pozdezh/Project_DELTA_Ph1/examples.jpg

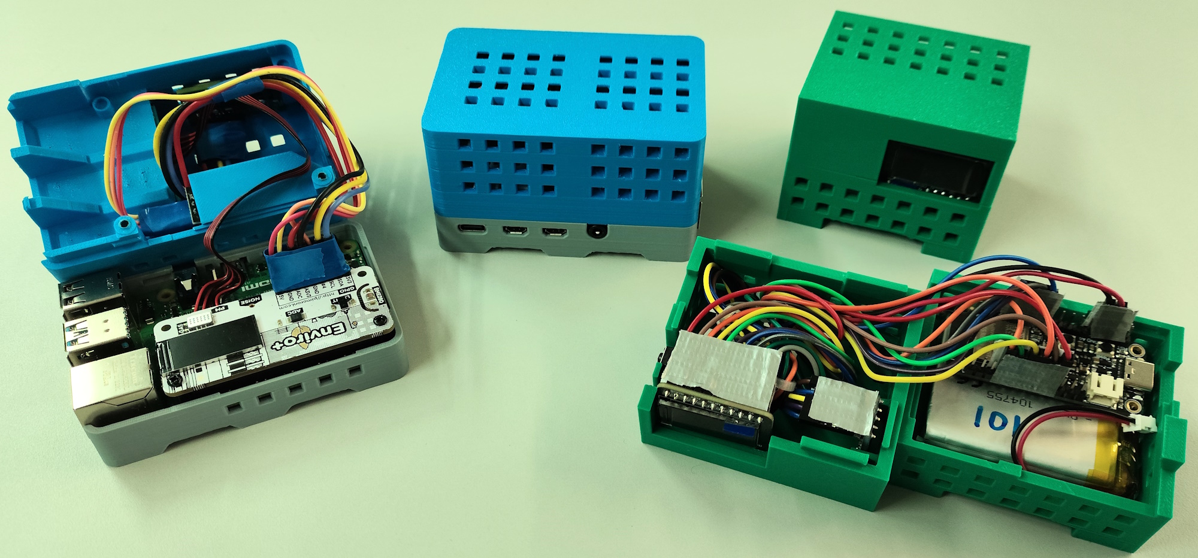
examples.jpg
