pozdezh/Project_DELTA_Ph1/README.md

# Project_DELTA_Ph1
TFG1 (GEB); 1st phase out of 2 in Smart Classroom final degree/research projects.

Task: Development of two sensor kits using IoT technology to measure, on the one hand, air quality and, on the other hand, noise. Study correlations between these factors based on measurements taken in a small office space.

The following research publication has resulted from the
study carried out in this work:

Edgar Batista, Constantin Shoot, Agustí Solanas, and Antoni Martínez-Ballesté, “Self-Organising and Autonomous IoT-based Monitoring Units
for Smart Environments”, 13th International Conference on Applications
in Electronics Pervading Industry, Environment and Society (ApplePies),
Torino, Italy, 11–12 September 2025.

This project builds on prior work:

E. Batista, A. Martínez-Ballesté, J. Rosell-Llompart, and A. Solanas.
"Towards Context-Aware Classrooms: Lessons Learnt from the ACTUA Project."
In: F. Bellotti et al. (eds) Applications in Electronics Pervading Industry,
Environment and Society. ApplePies 2023. Lecture Notes in Electrical Engineering, vol 1110.
Springer, Cham. https://doi.org/10.1007/978-3-031-30333-3_45
