pozdezh/Project_DELTA_Ph1/AirQ/Code/README.md

This code builds on prior research from the ACTUA Project, and has been adapted for the current Smart Environments project.

Prior work:

E. Batista, A. Martínez-Ballesté, J. Rosell-Llompart, and A. Solanas.
"Towards Context-Aware Classrooms: Lessons Learnt from the ACTUA Project."
In: F. Bellotti et al. (eds) Applications in Electronics Pervading Industry, Environment and Society (ApplePies 2023), Lecture Notes in Electrical Engineering, vol 1110. Springer, Cham.
https://doi.org/10.1007/978-3-031-30333-3_45

Current work:

E. Batista, C. Shoot, A. Solanas, and A. Martínez-Ballesté.
"Self-Organising and Autonomous IoT-based Monitoring Units for Smart Environments."
Smart Technologies Research Group, Universitat Rovira i Virgili.
