pozdezh/Project_DELTA_Ph1/docs/TFG_Shoot_Biomed.pptx

Constantin Shoot Vayevoda

Development of a Contextual Sensing Kit to Assess the Relationship Between Air Quality and Noise

Treball de Fi de Grau en Enginyeria Biomèdica

dirigit per Edgar Batista de Frutos i Antoni Martínez Ballesté

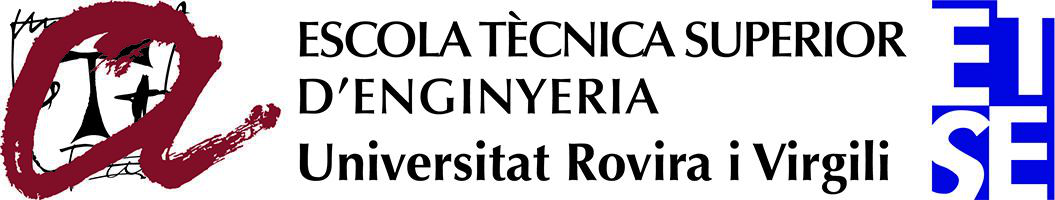
[picture p2: figure]

Tarragona

2025

## Contents

1. Introduction & Motivation
2. Objectives & Theoretical Basis
3. Design & Implementation
4. Validation & Experiment Setup
5. Results & Discussion
6. Future Work
7. Conclusions

## 1: Motivation and problem

- IEQ impacts comfort and learning
- Current solutions are ad hoc, hard to compare
- Issues: heterogeneity, manual setup, weak synchronisation
- Need modular kits with accurate timestamping and privacy

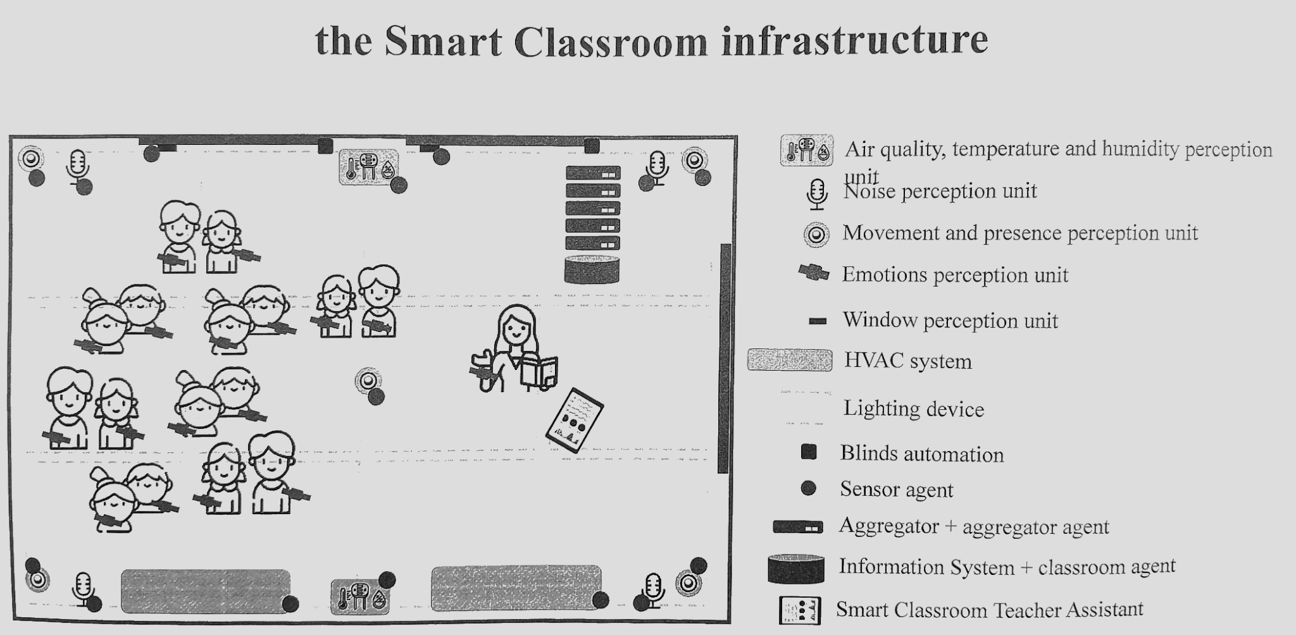
[picture p3: figure]

## 2.1: Objectives

- Build two modular kits: AirQ (air quality) & Noise (voice-band)
- Accurate, timestamped on-device data retention; light IoT hooks
- Compact 3D-printed enclosures for indoor use
- Validate in real context; initial air–noise correlation analysis
- Phase 1 groundwork boundary: networking & cloud deferred to Phase 2

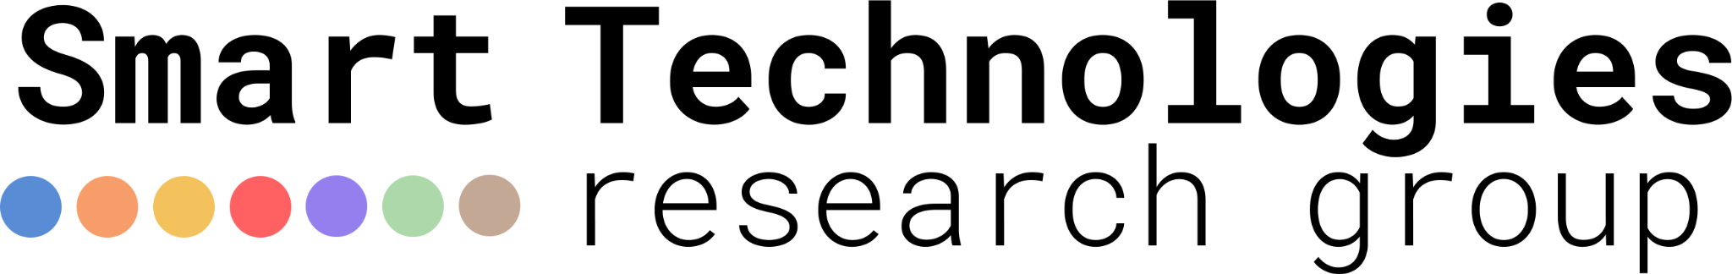
[picture p4: figure]

## 2.2: RTOS and ESP32

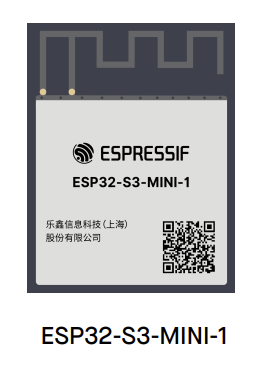
[picture p5: figure]
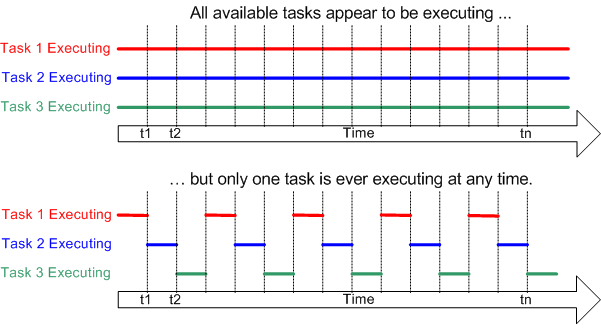
[picture p6: figure]
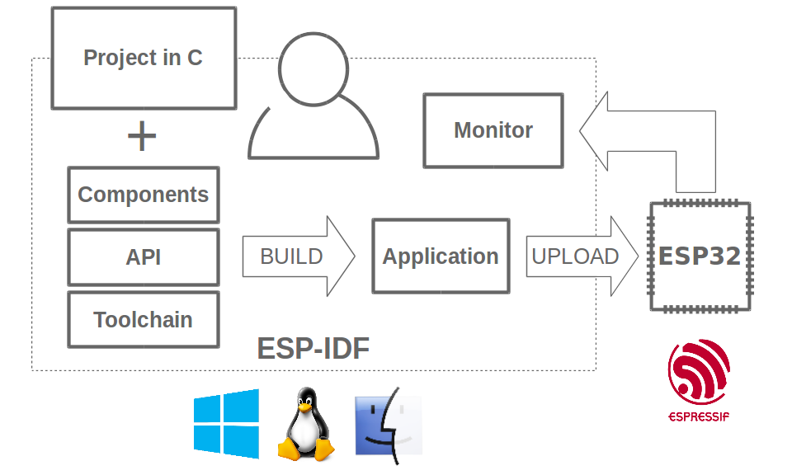
[picture p7: figure]

www.espressif.com

www.freertos.org

## 2.3: Discrete Fourier Transform and FFT

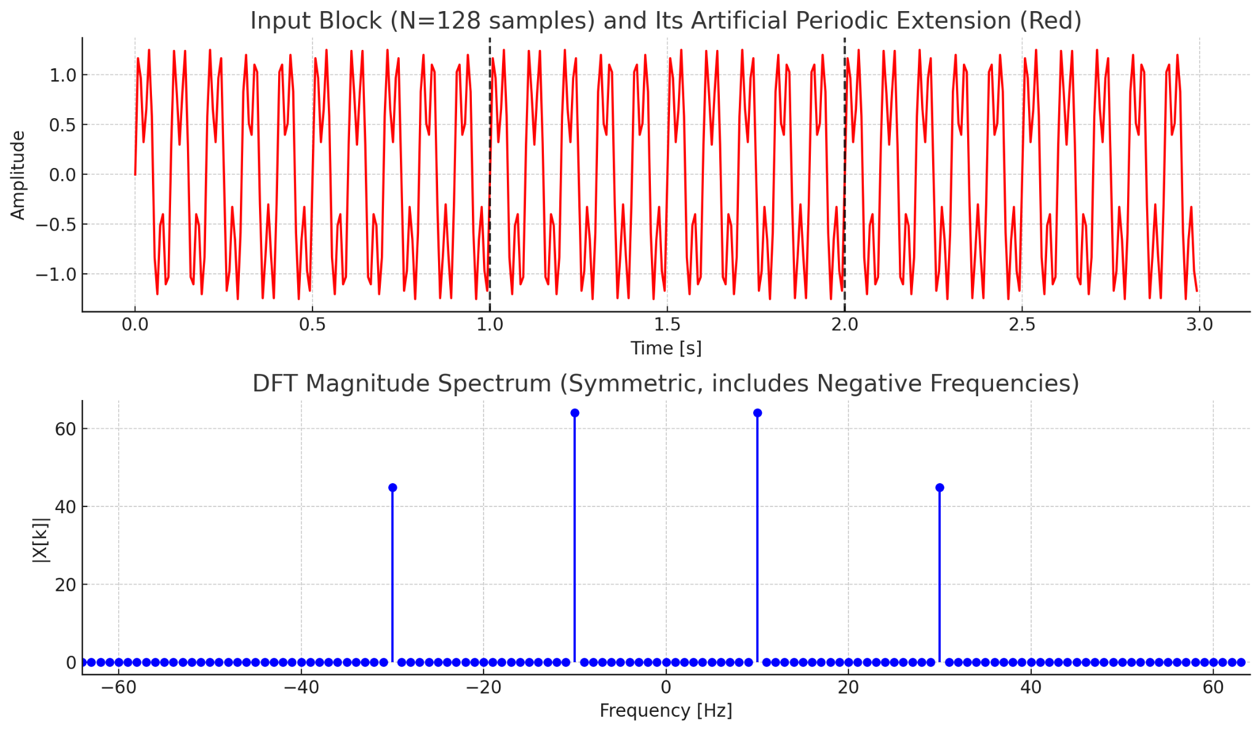
[picture p8: figure]
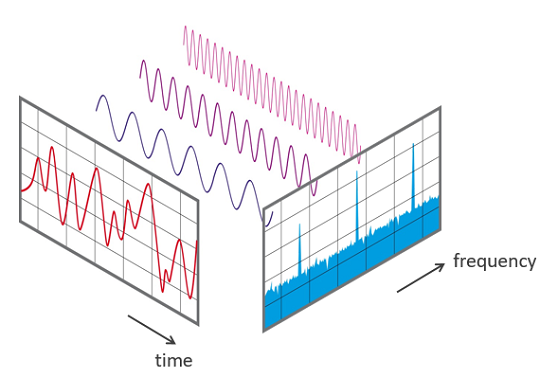
[picture p9: figure]

www.allaboutcircuits.com

## 2.3: “Speech Banana”

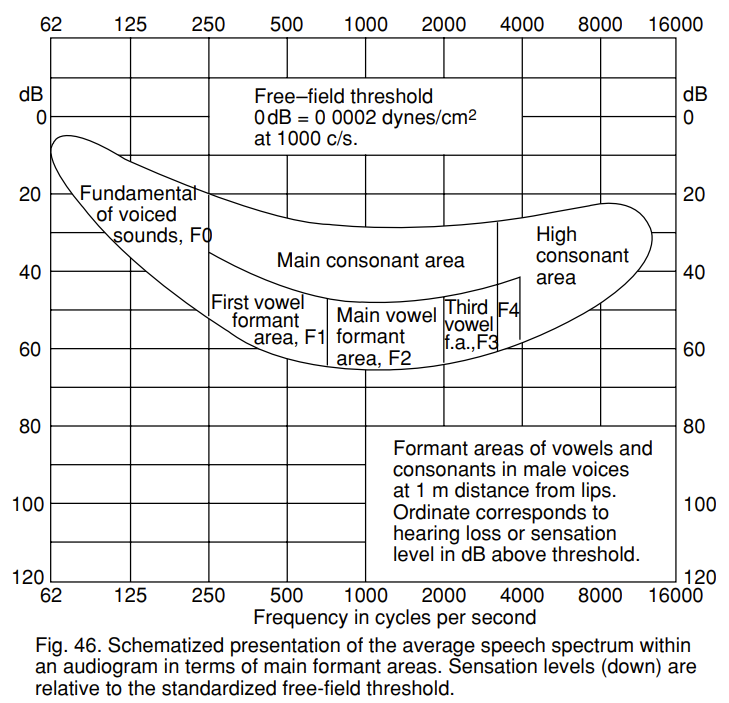
[picture p10: figure]

## 2.4: 3D printing and PLA

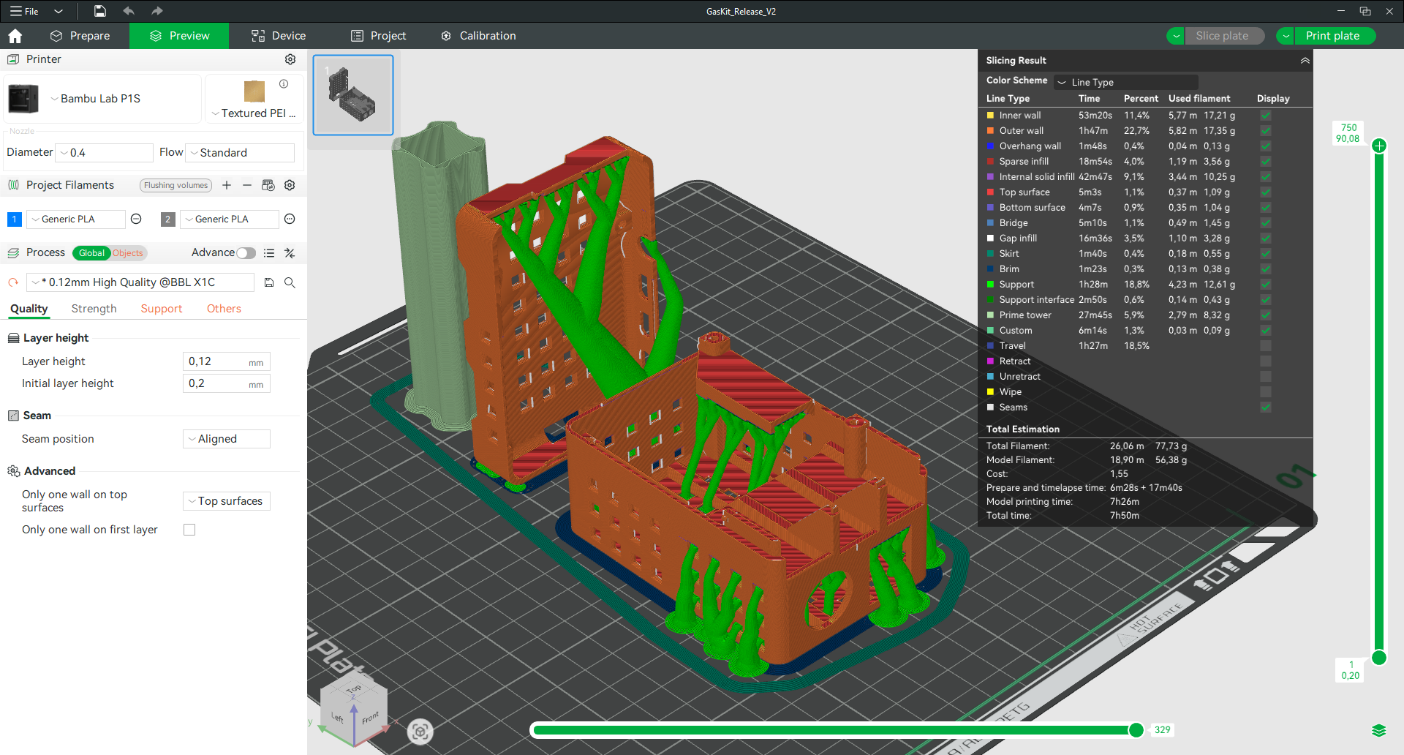
[picture p11: figure]
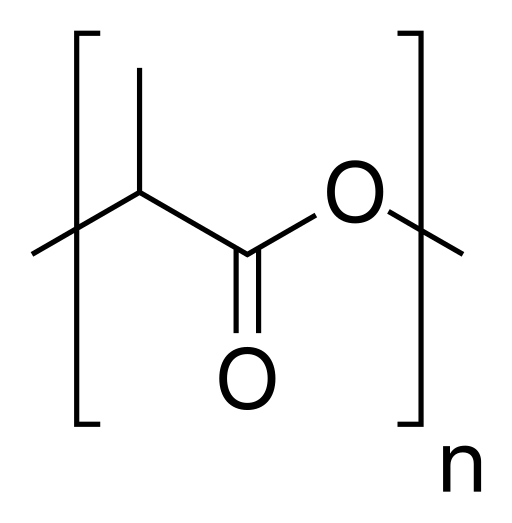
[picture p12: figure]

## 2.5: Data science

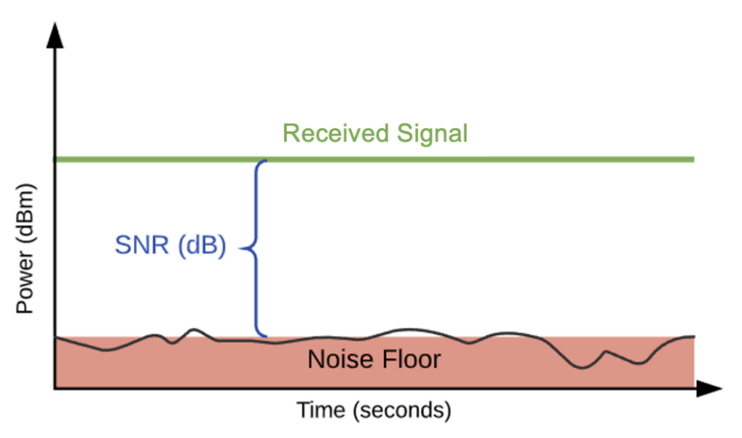
[picture p13: figure]
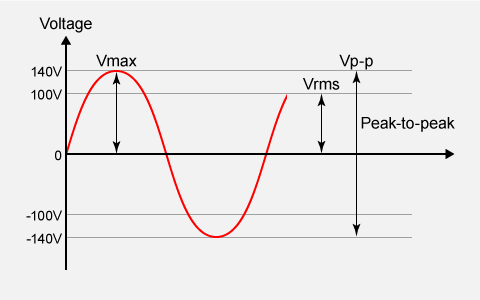
[picture p14: figure]

www.hollyland.com

www.matsusada.com

## 2.5: Data science

- H0/H1 testing for Pearson r
- Lagged alignment
- Autocorrelation addressed
- False discovery rate
- Slow trends considered

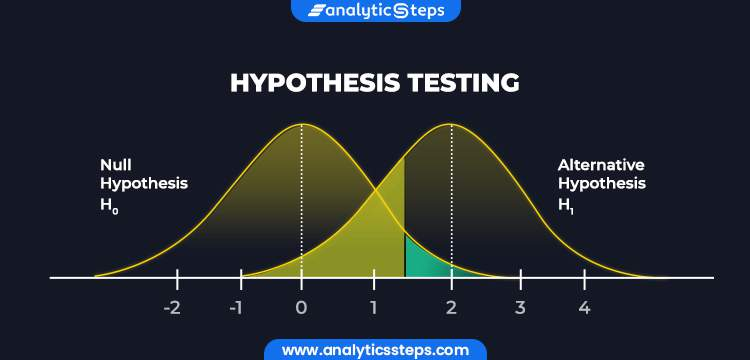
[picture p15: figure]

## 3.1: Budget

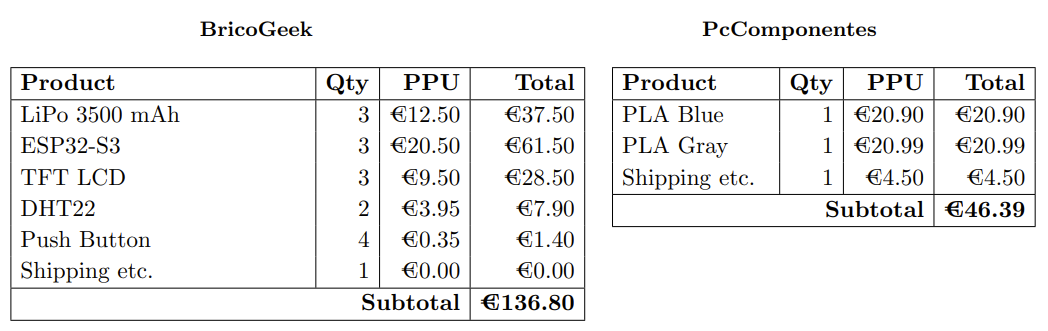
[picture p16: figure]

## 3.2: Kits produced

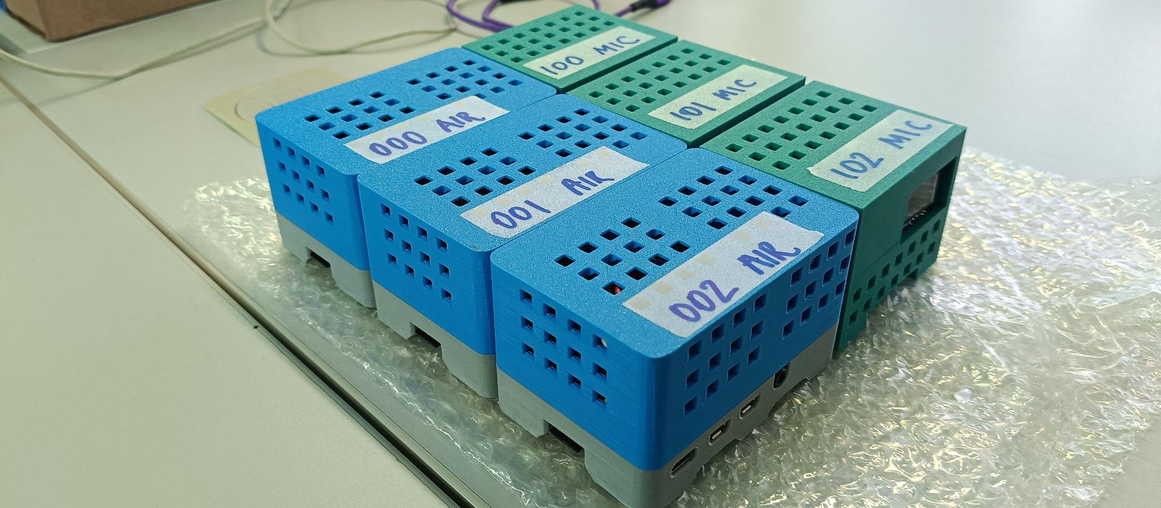
[picture p17: figure]
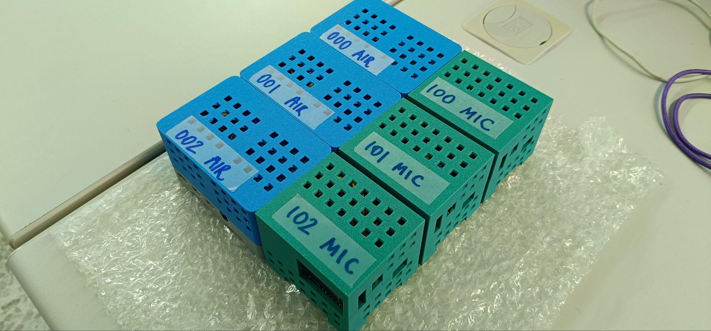
[picture p18: figure]
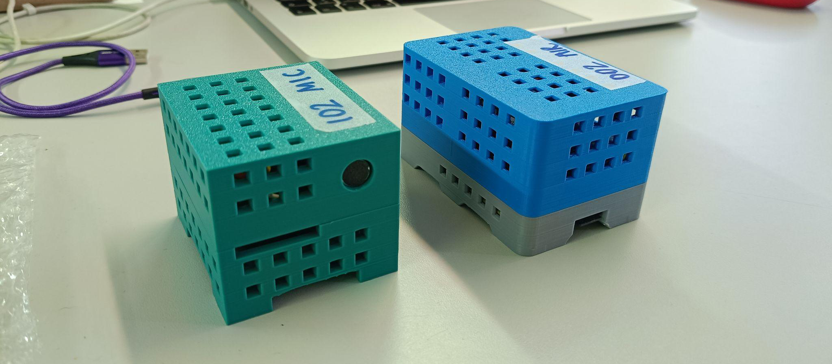
[picture p19: figure]

## 3.3: AirQ kit hardware

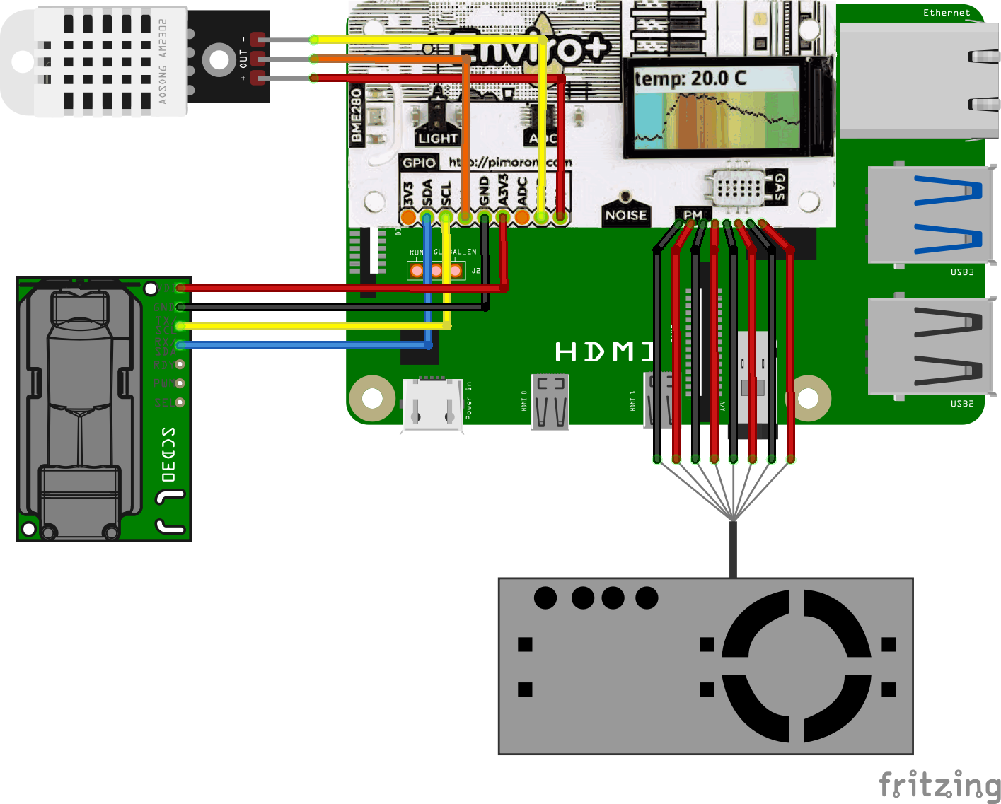
[picture p20: figure]

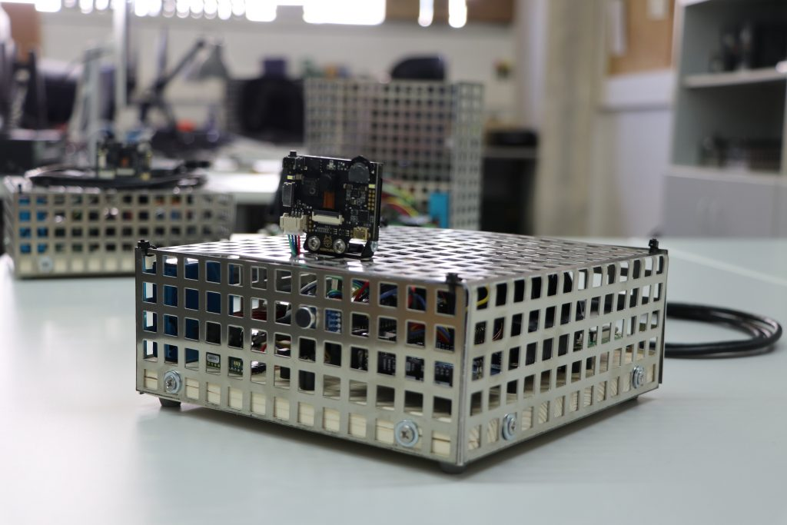
[picture p21: figure]

## 3.3: AirQ kit hardware

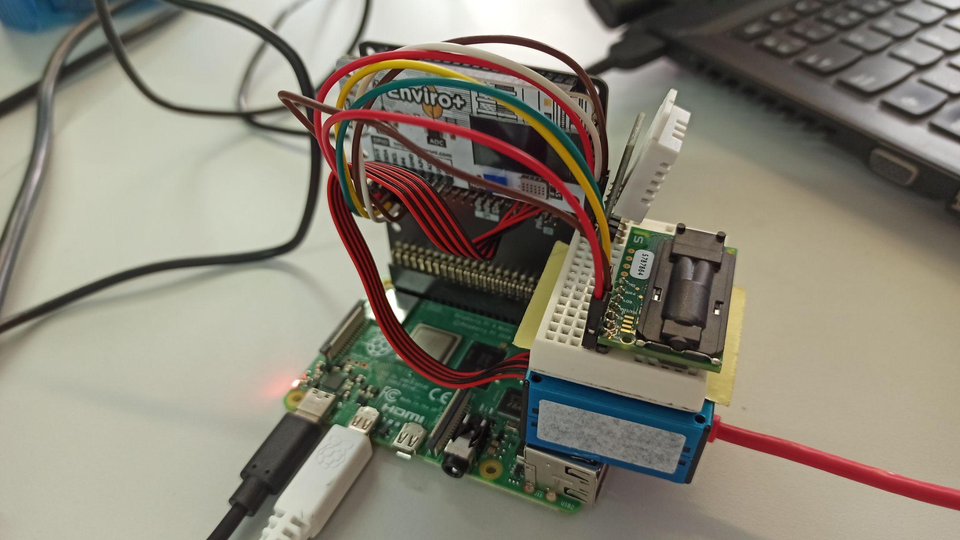
[picture p22: figure]
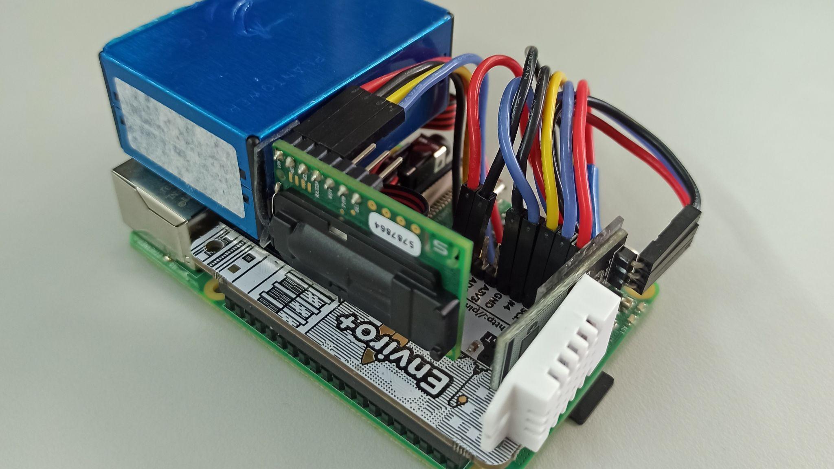
[picture p23: figure]

## 3.4: AirQ kit enclosure

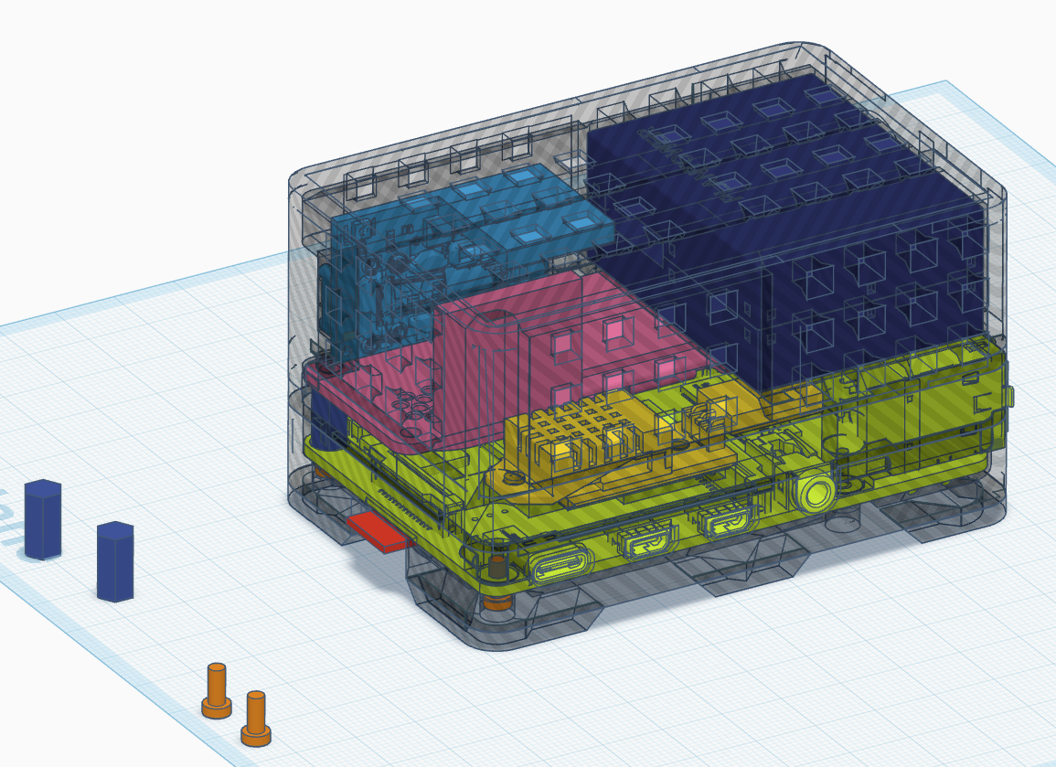
[picture p24: figure]
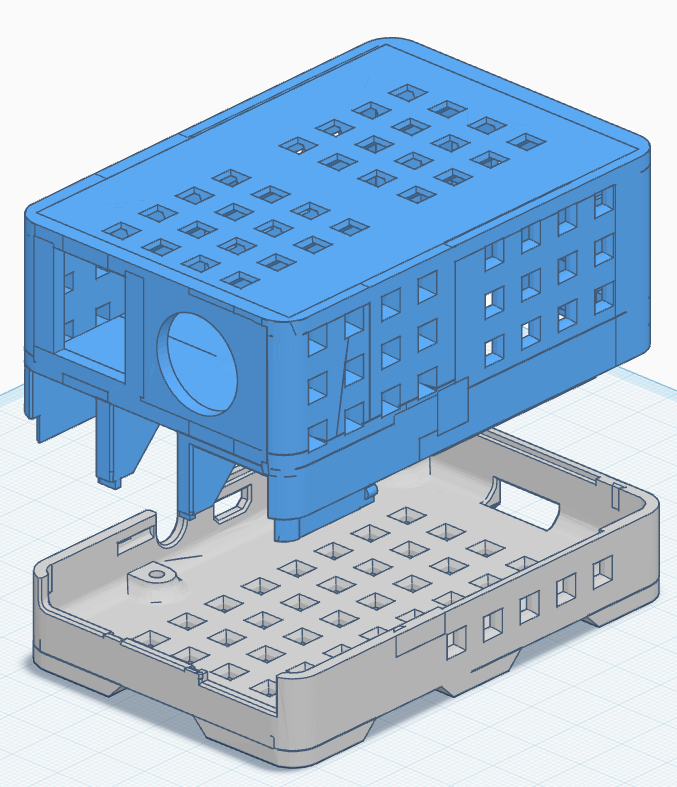
[picture p25: figure]

## 3.4: AirQ kit enclosure

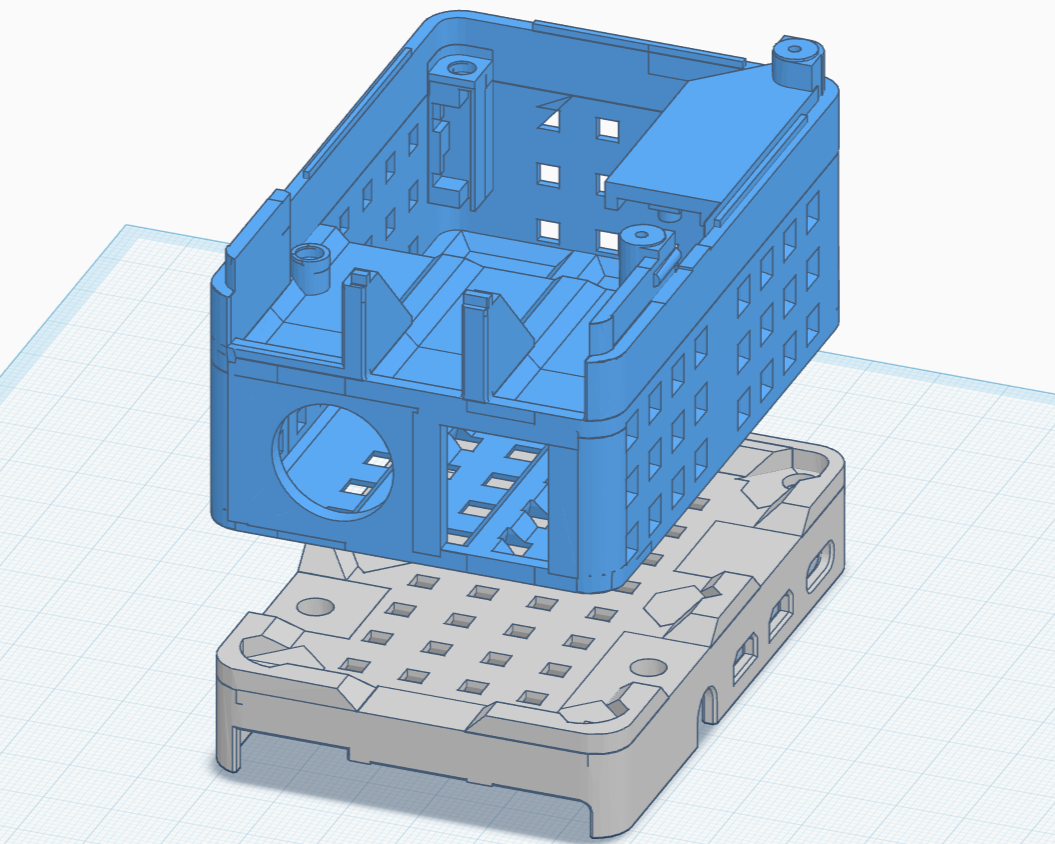
[picture p26: figure]

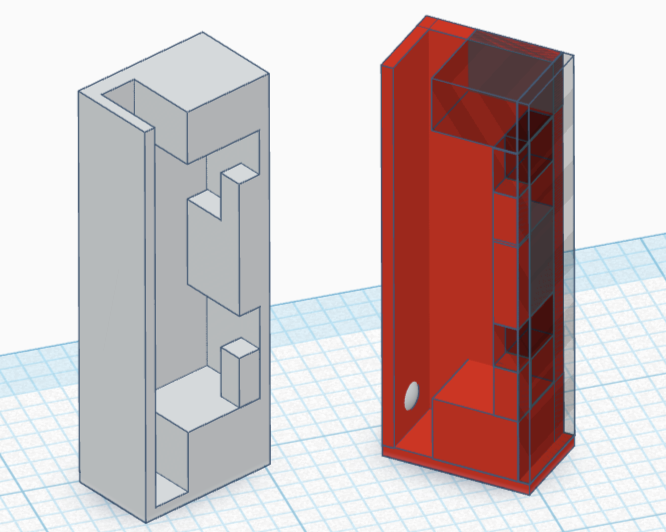
[picture p27: figure]

## 3.4: AirQ kit enclosure

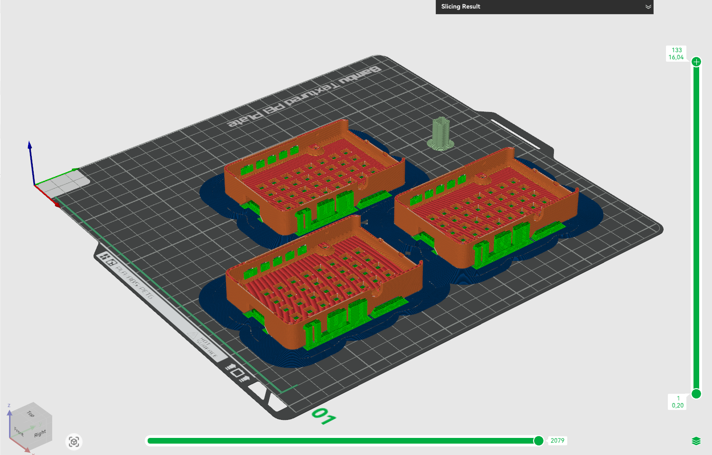
[picture p28: figure]
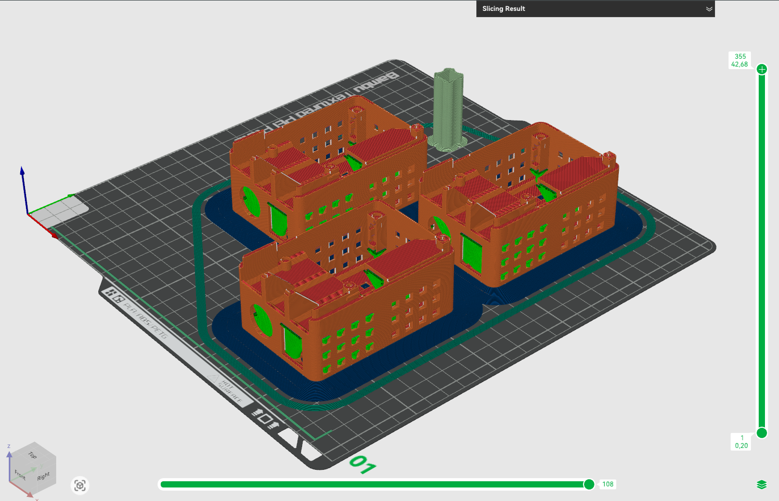
[picture p29: figure]

## 3.4: AirQ kit enclosure

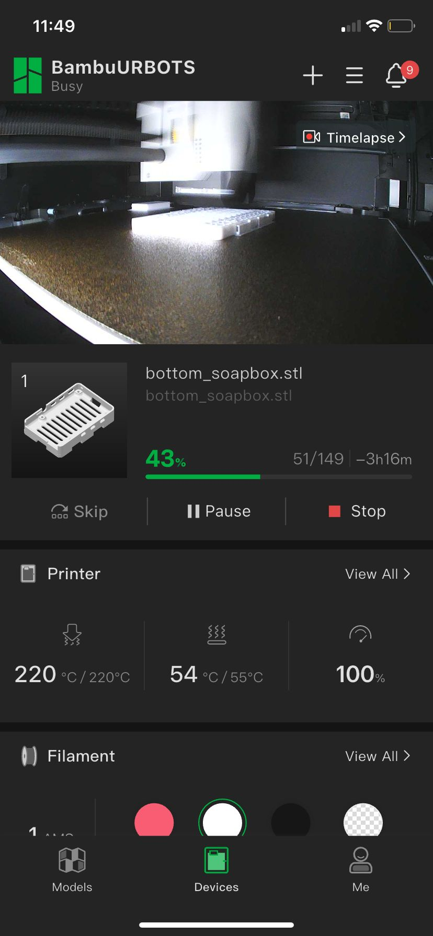
[picture p30: figure]
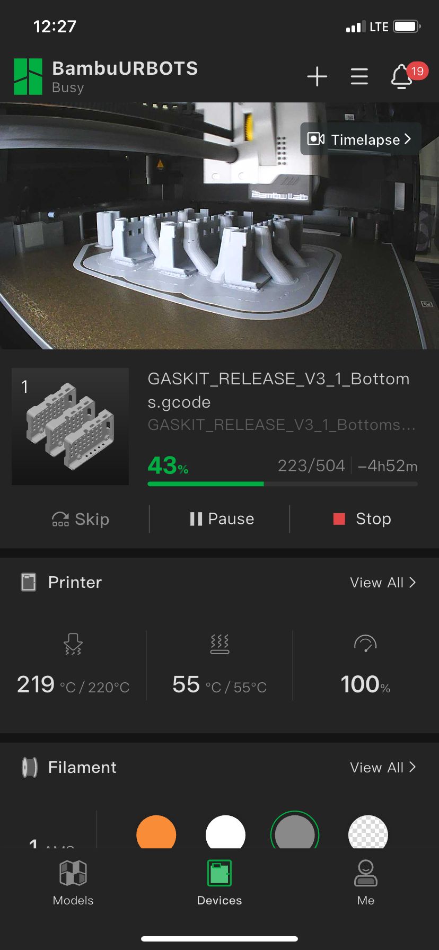
[picture p31: figure]
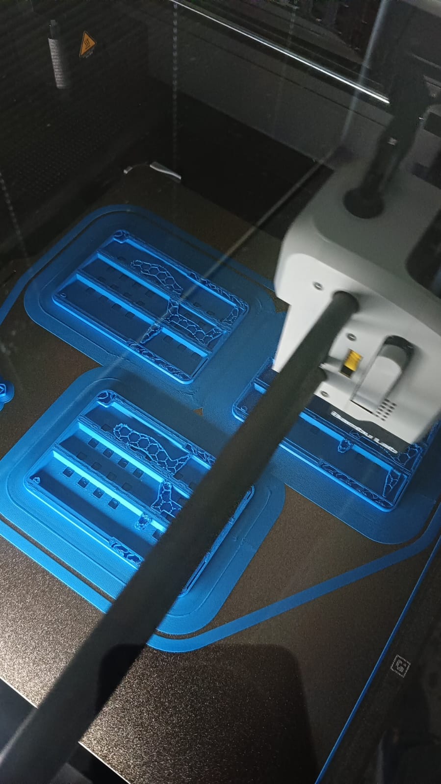
[picture p32: figure]
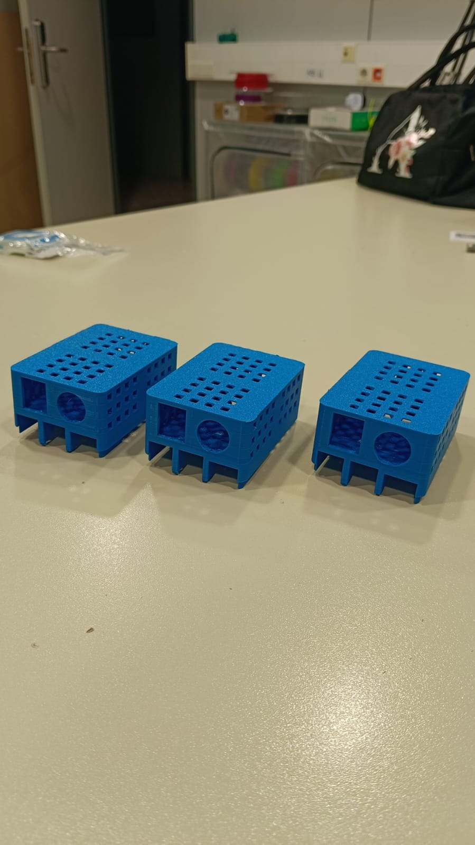
[picture p33: figure]

## 3.4: AirQ kit enclosure

## 3.5: AirQ kit software

- ACTUA legacy code modified
- SQLite logging
- Control scripts
- Easy installation
- Modular
- Temp./Hum., pressure, PM, CO2, Illuminance

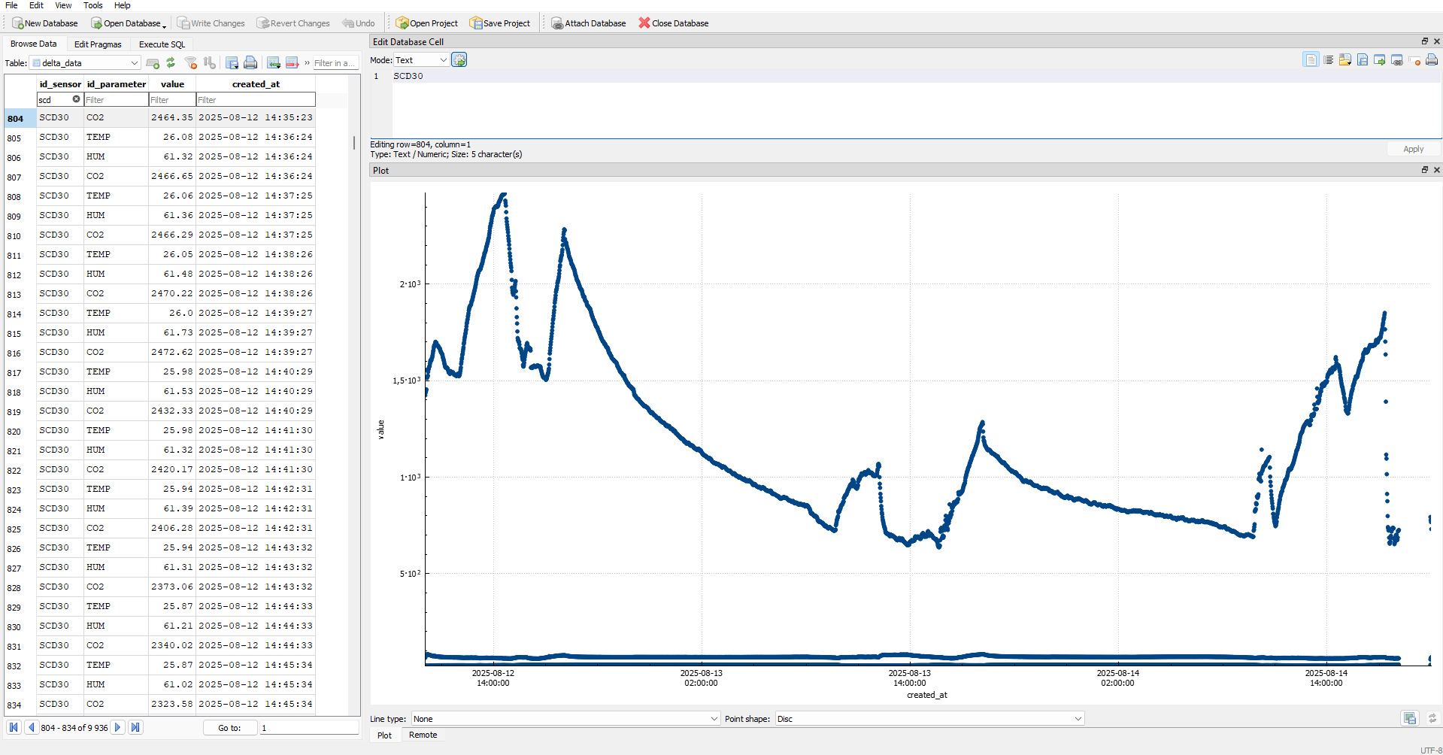
[picture p34: figure]

## 3.6: Noise kit hardware

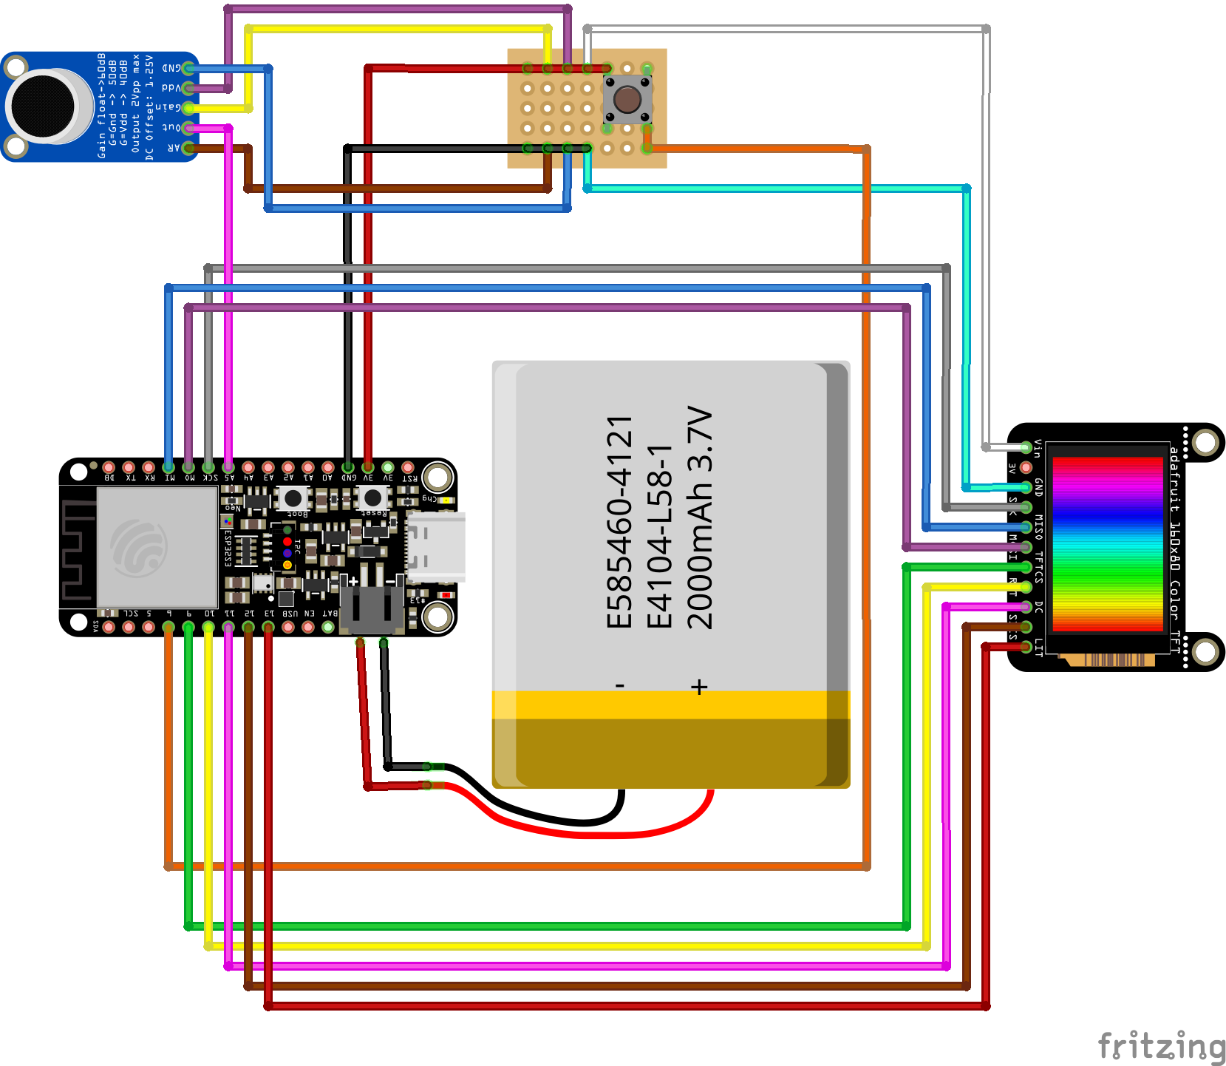
[picture p35: figure]

## 3.6: Noise kit hardware

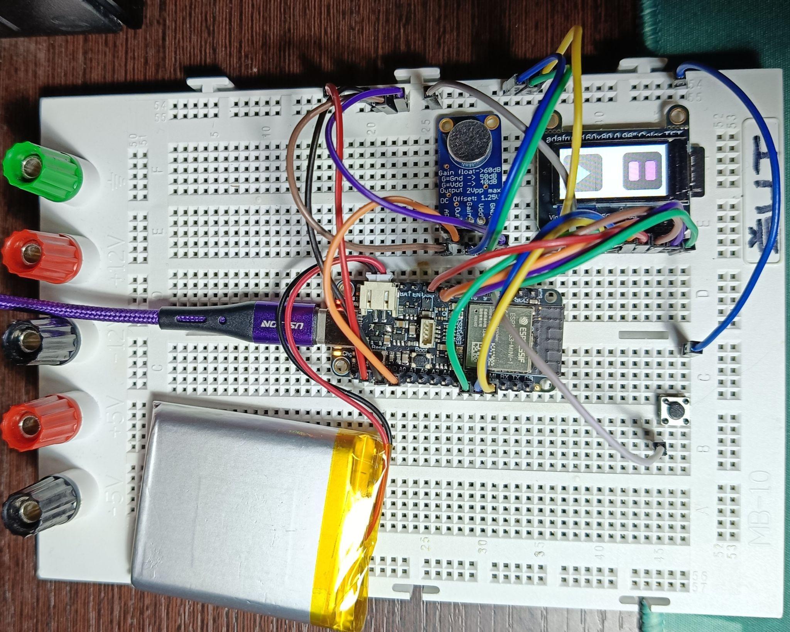
[picture p36: figure]
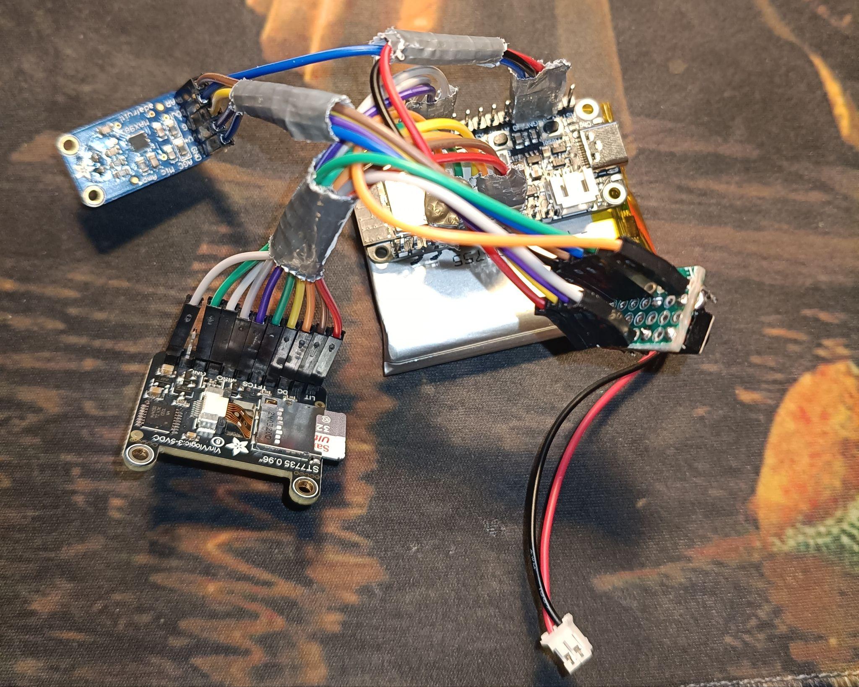
[picture p37: figure]

## 3.7: Noise kit 3D enclosure

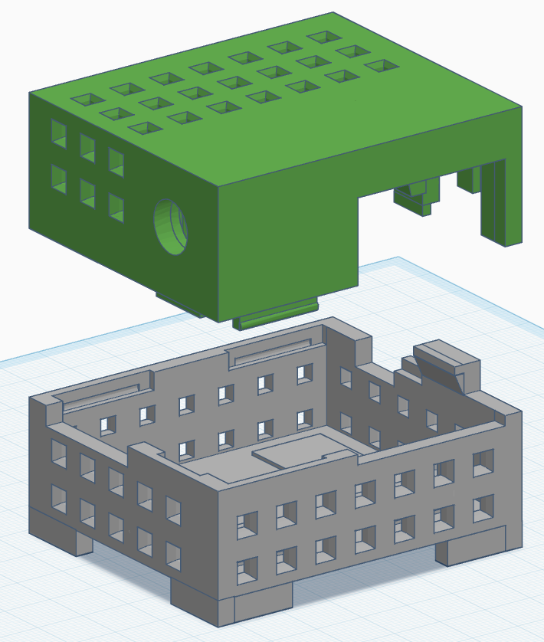
[picture p38: figure]
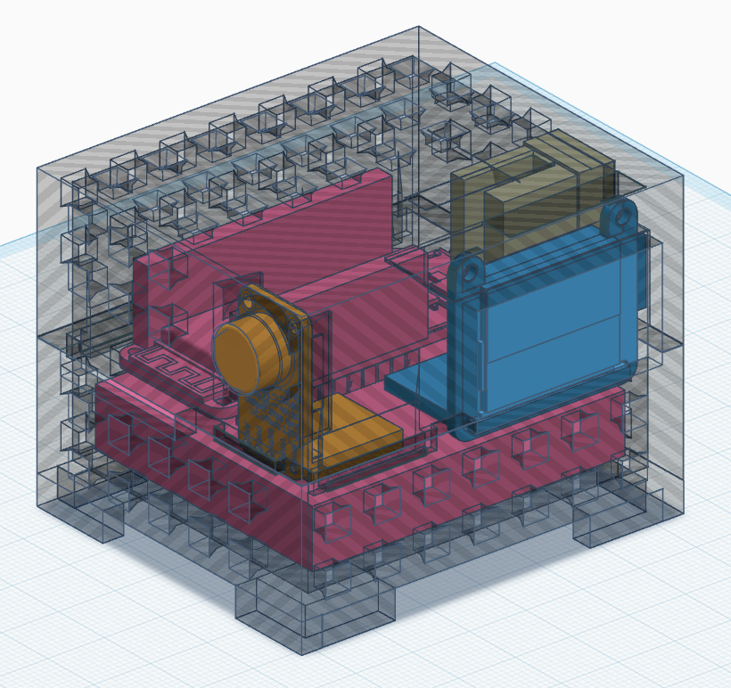
[picture p39: figure]

## 3.7: Noise kit 3D enclosure

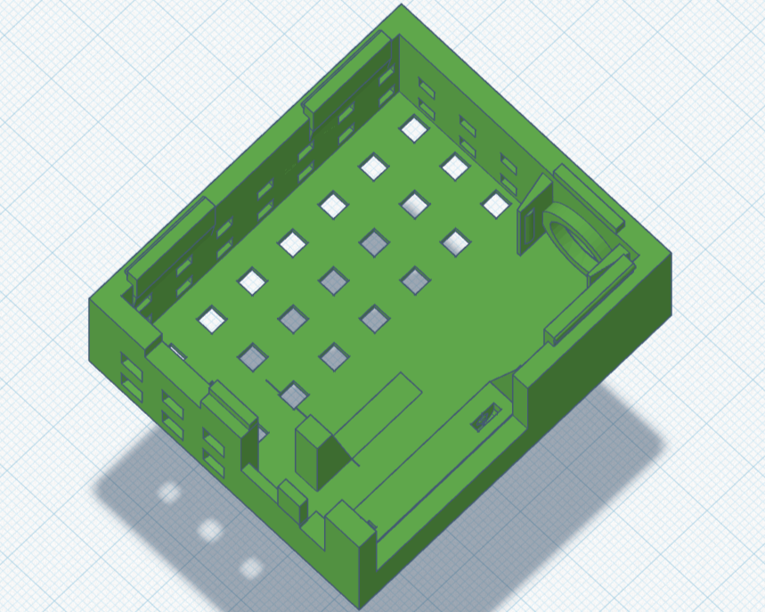
[picture p40: figure]
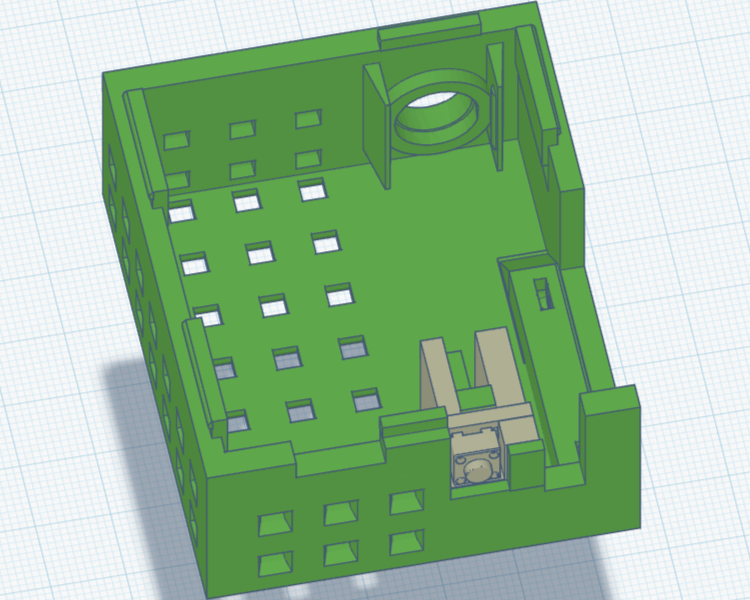
[picture p41: figure]

## 3.7: Noise kit 3D enclosure

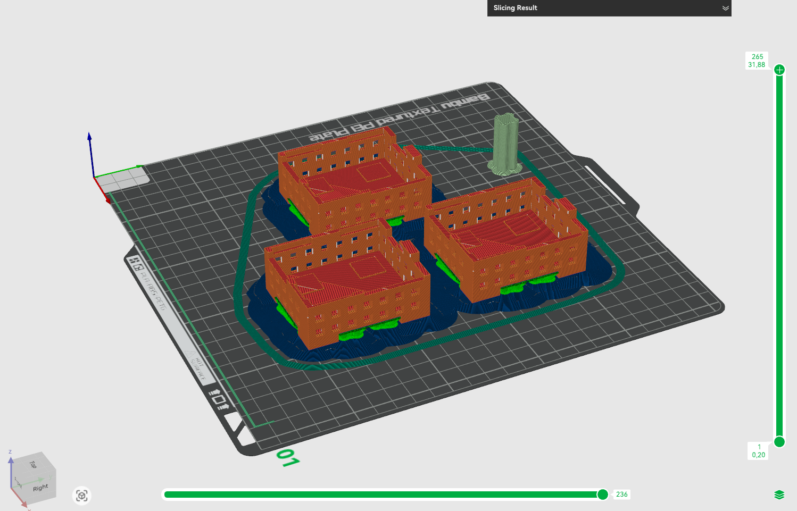
[picture p42: figure]
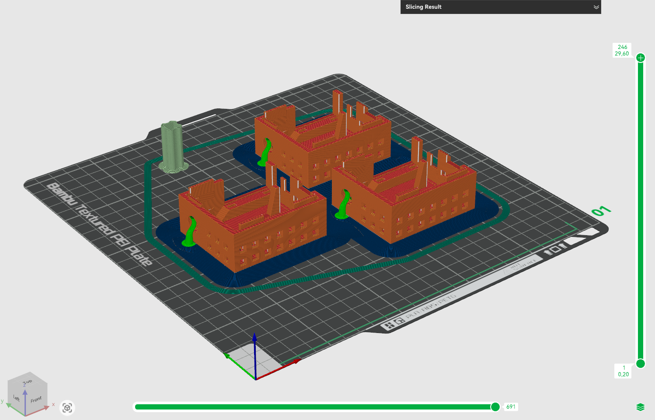
[picture p43: figure]

## 3.7: Noise kit 3D enclosure

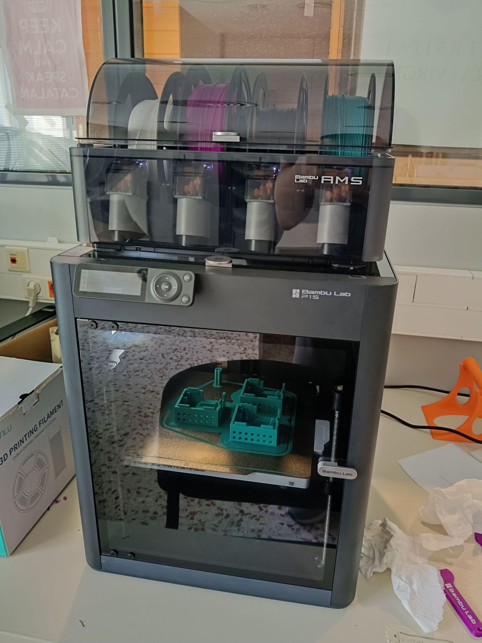
[picture p44: figure]
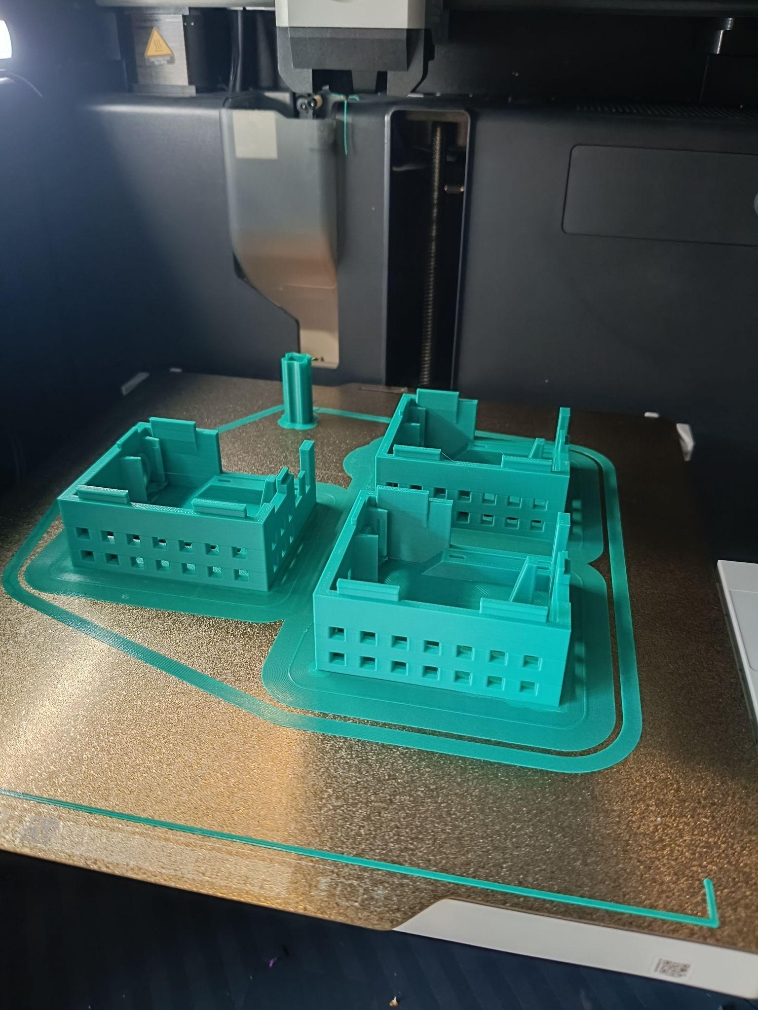
[picture p45: figure]

## 3.8: Noise kit firmware

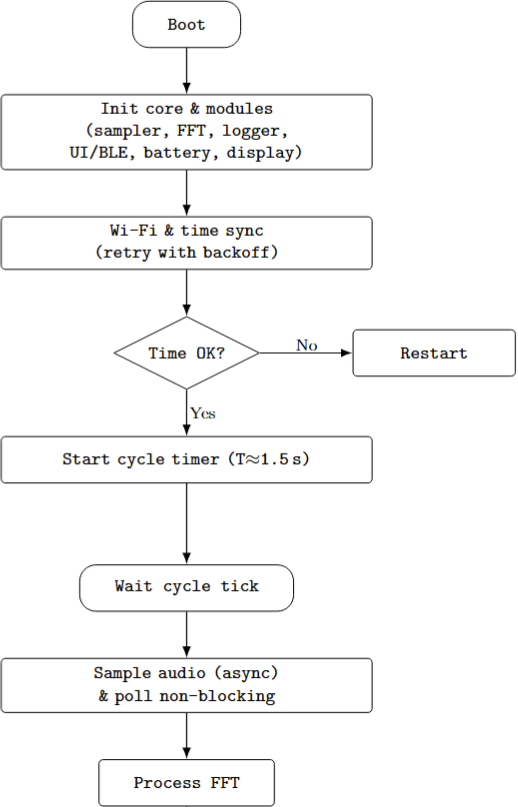
[picture p46: figure]
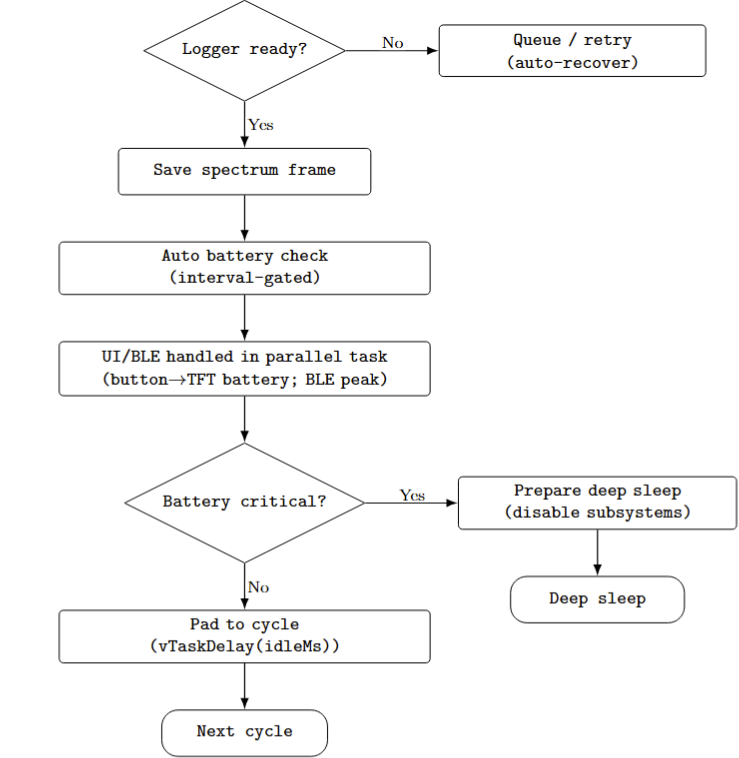
[picture p47: figure]

## 3.8: Noise kit firmware

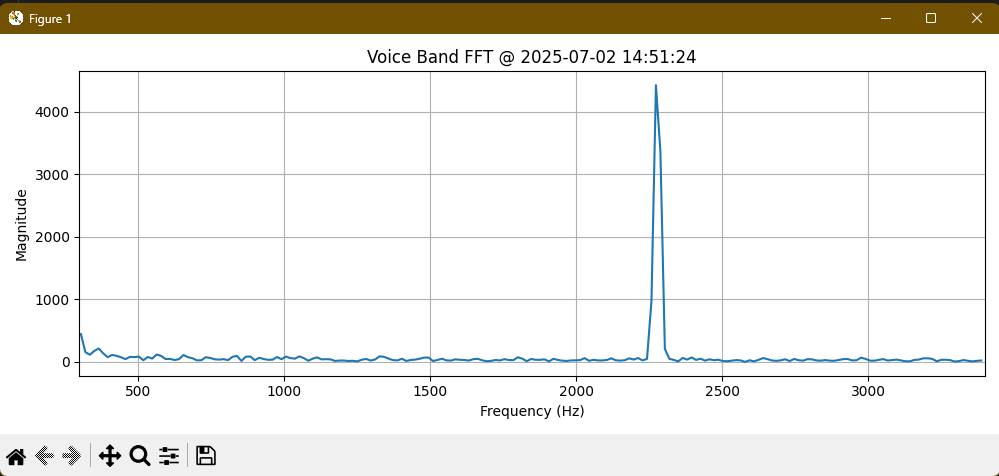
[picture p48: figure]
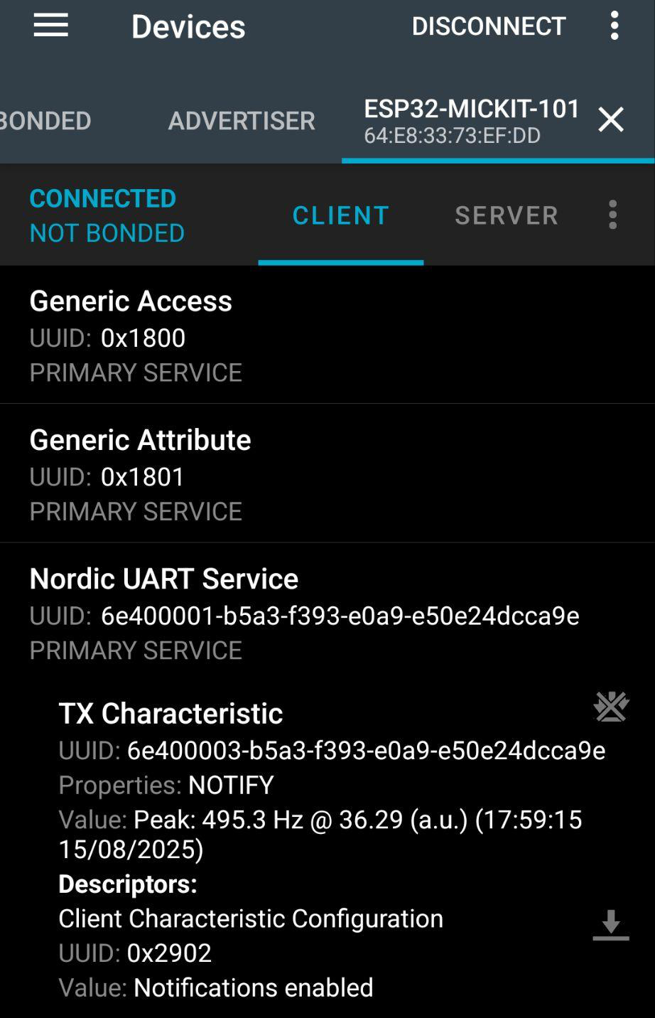
[picture p49: figure]

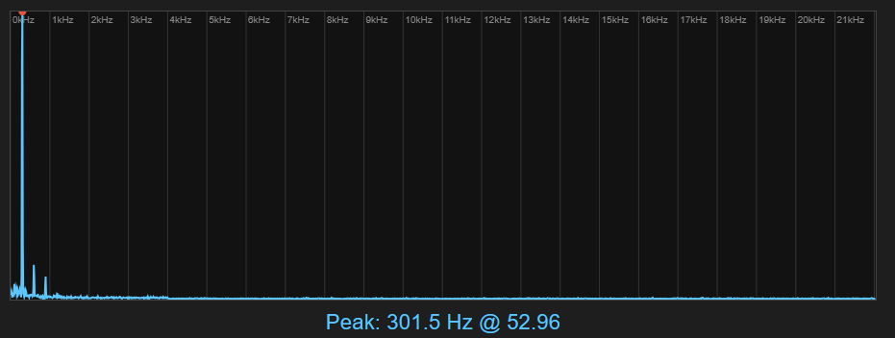
[picture p50: figure]

## 3.9: Data analysis software

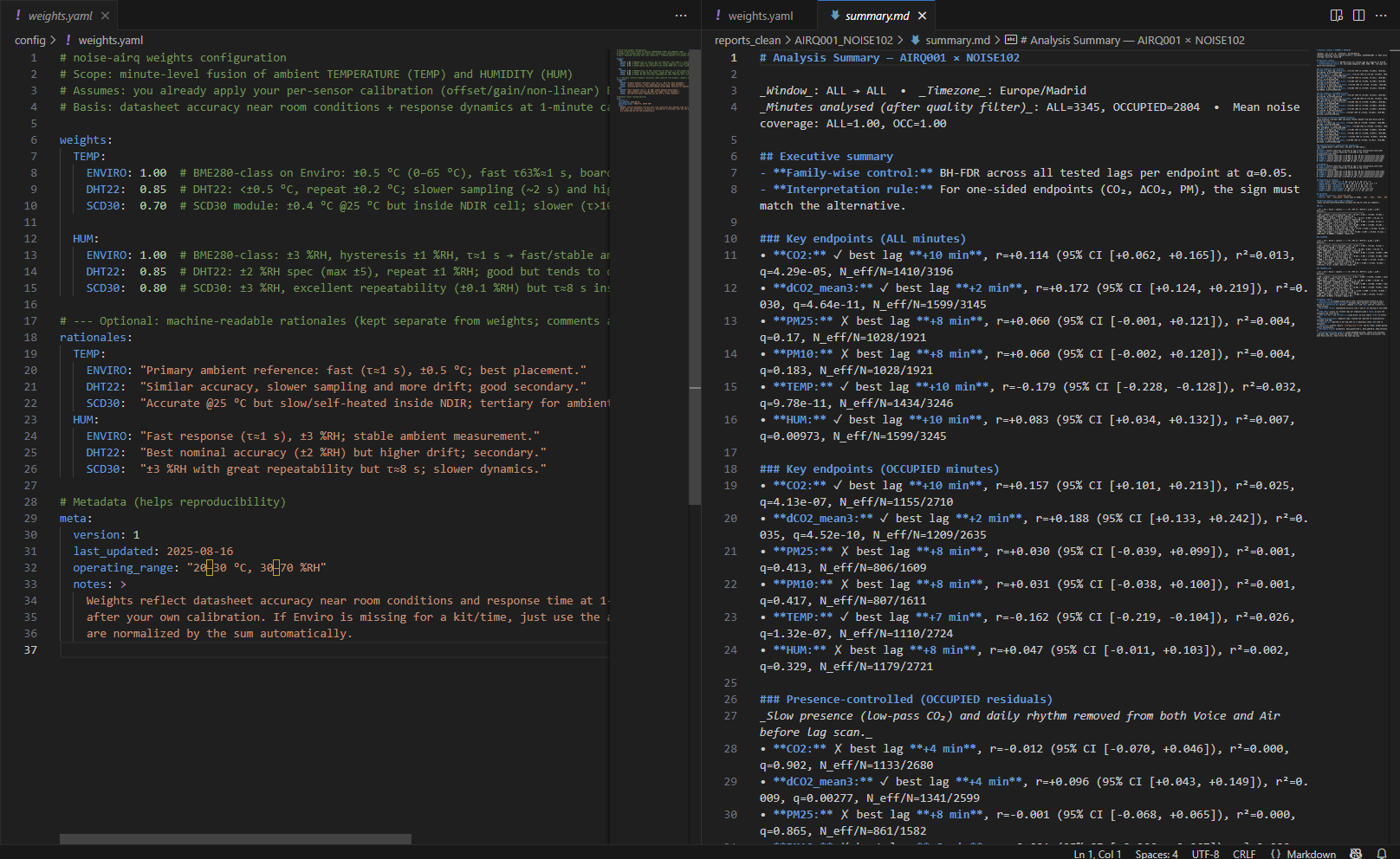
[picture p51: figure]

- Python pipeline → columnar intermediates
- Configuration YAMLs
- Noise: decode binary logs → voice derivatives, per-minute aggregation
- AirQ: pull DB → fuse redundant, per-minute aggregation
- Align & analyse

## 4.1: Pre-deployment validation

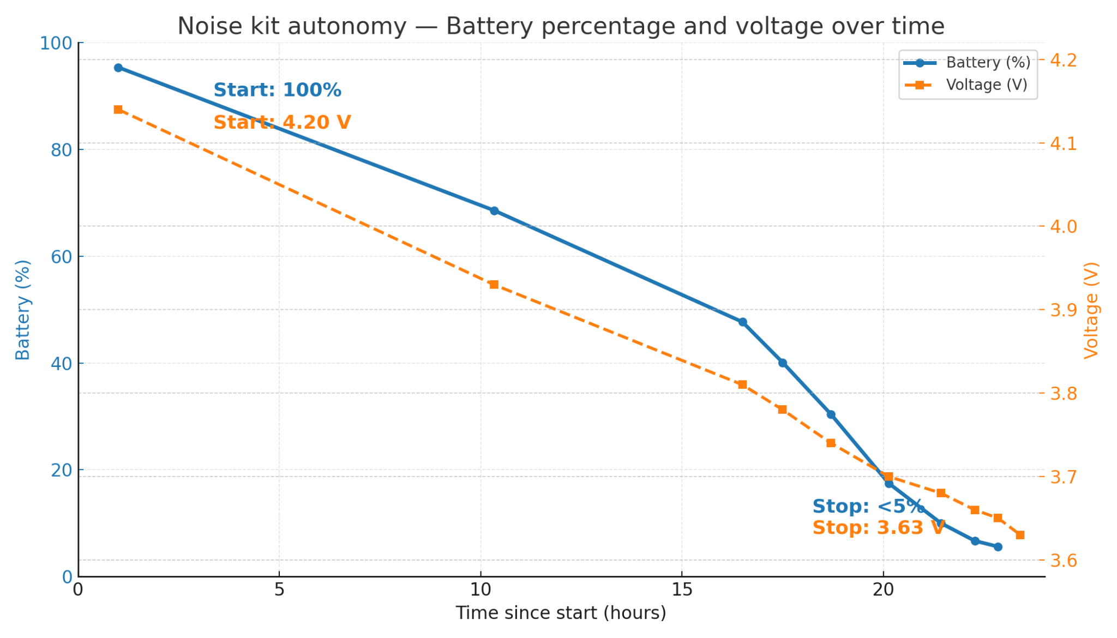
[picture p52: figure]
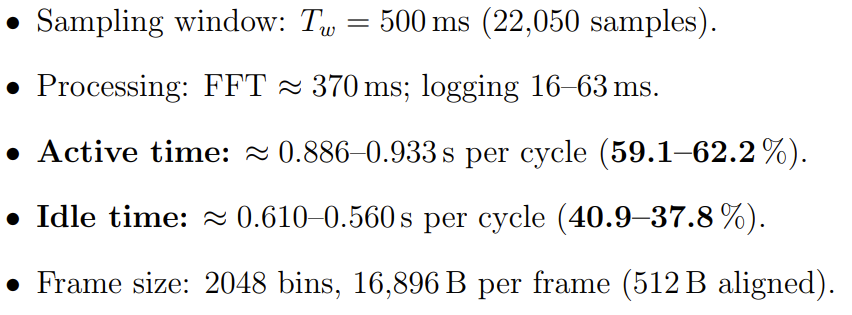
[picture p53: figure]

## 4.2: Experimental setup

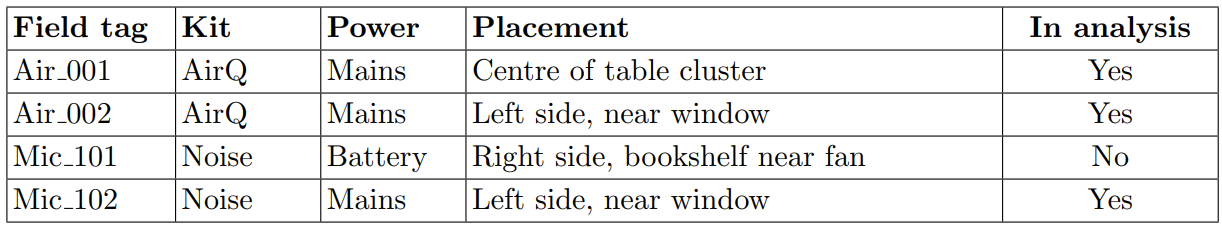
[picture p54: figure]
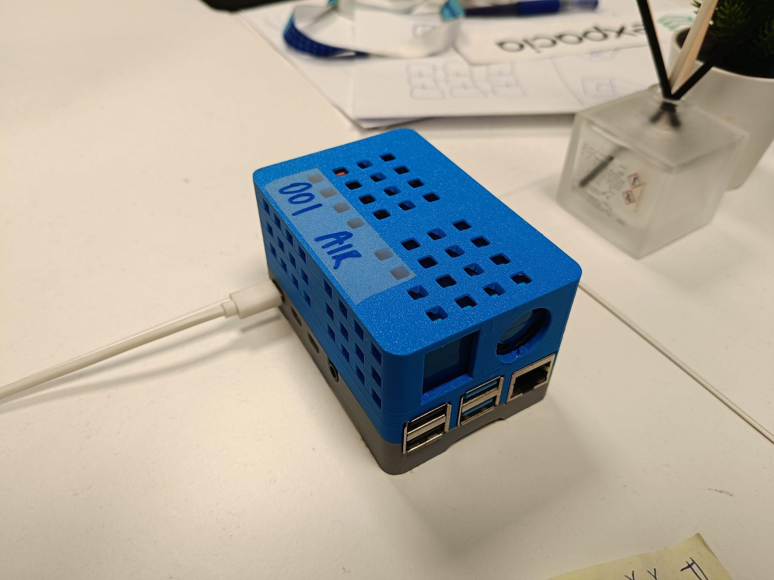
[picture p55: figure]
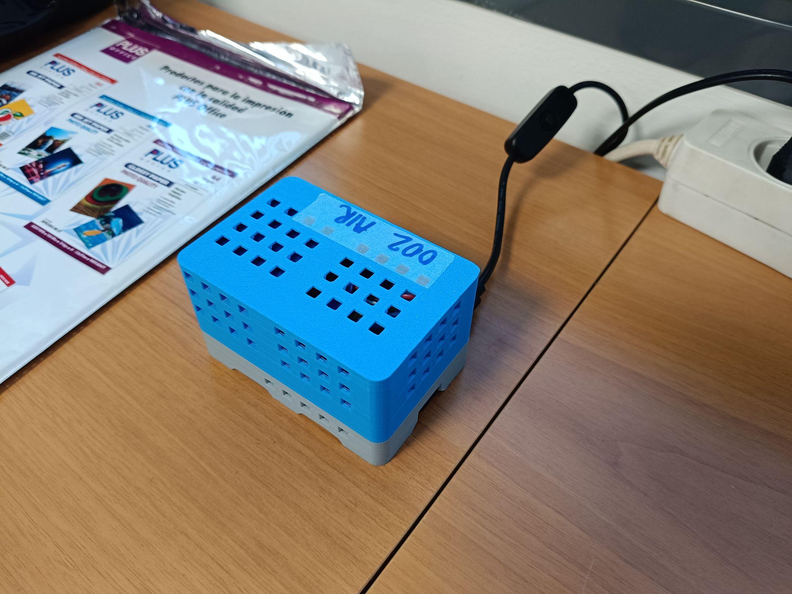
[picture p56: figure]
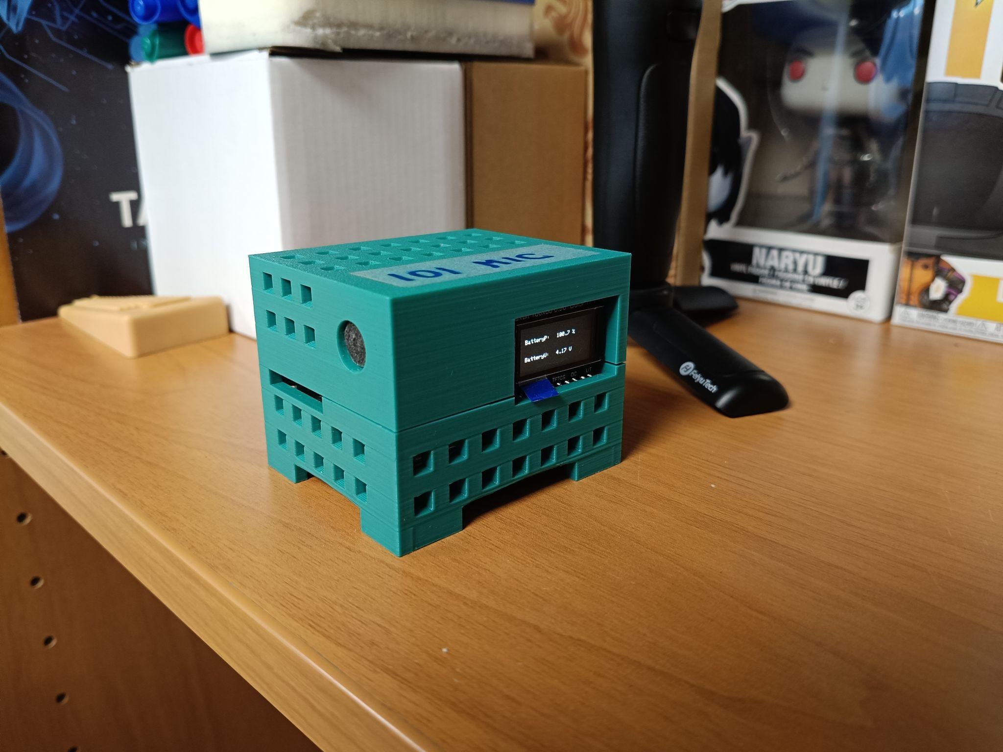
[picture p57: figure]
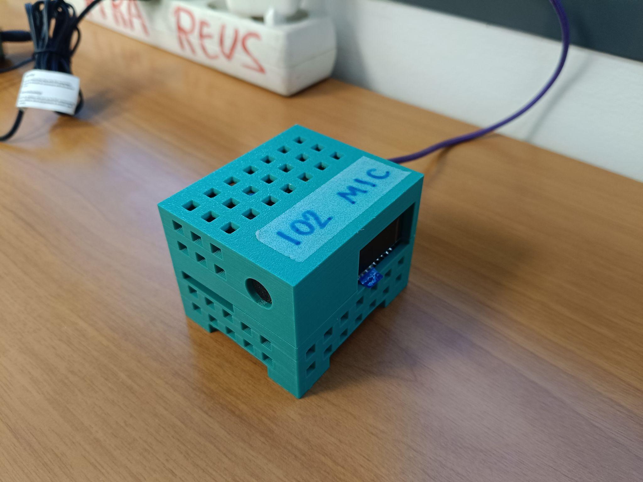
[picture p58: figure]

## 5: Results and discussion

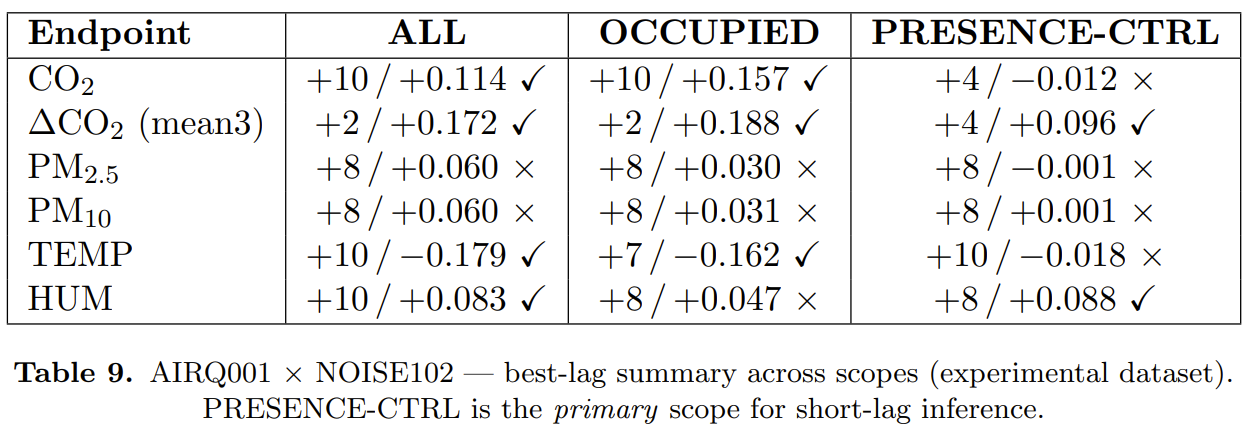
[picture p59: figure]

- Primary scope: presence-controlled (slow trends removed)
- +4 min lag across locations for primary scope
- Temp./Hum. likely HVAC driven
- Correlational findings; causation not assured

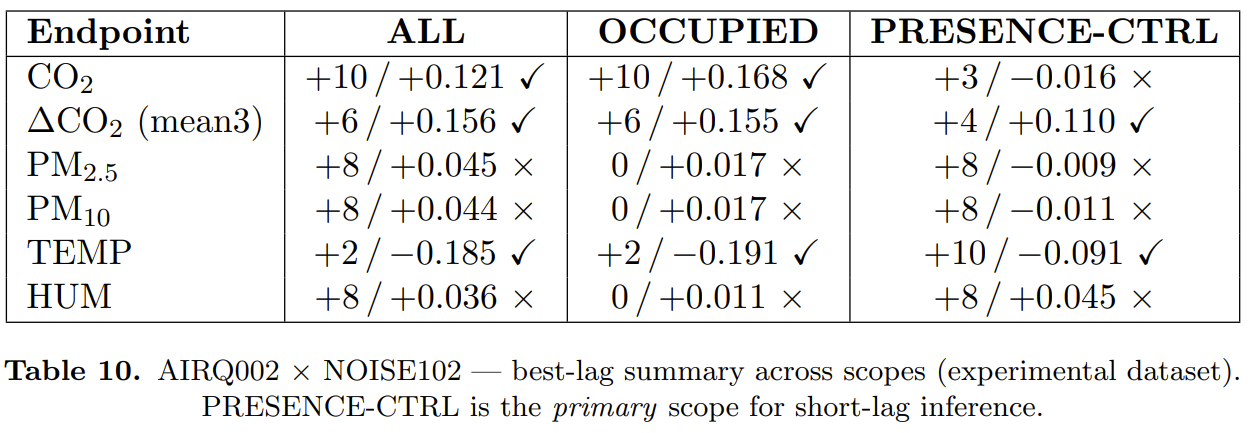
[picture p60: figure]

## 6: Future work: Phase 1 → Phase 2

- Self-organising, scalable fleet
- Dynamic duty cycle, tuned settings
- Embedded processing models, data privacy and security
- Minimal on-device data storage, ephemeral buffers usage

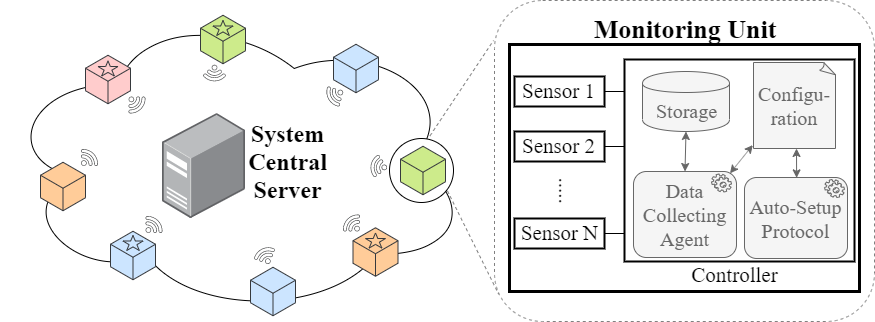
[picture p61: figure]

## 7: Conclusions

- Delivered: functional, reproducible contextual AirQ + Noise sensing kits
- Legacy code and components recycled when possible
- Modular structure across layers
- ΔCO₂ correlation with human voice
- Public repository available
- Solid foundation for Phase 2 software improvement

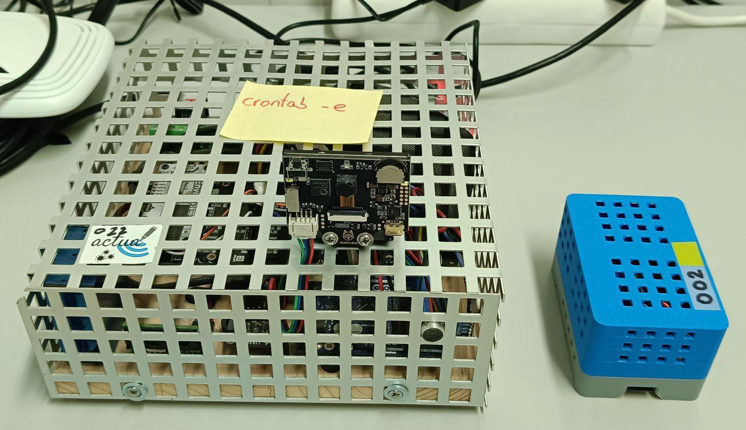
[picture p62: figure]

## Thank you for your attention! Questions are welcome

## Slide 36

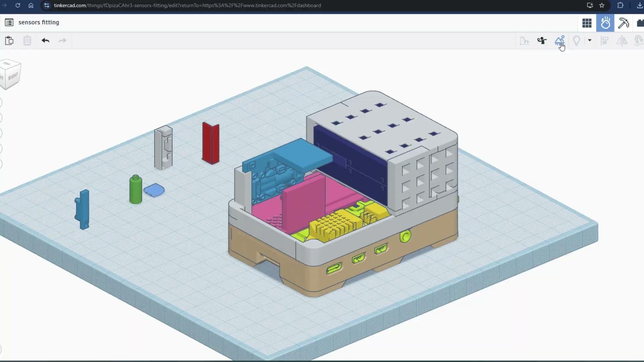
[picture p63: figure]
