pozdezh/Project_DELTA_Ph1/Data_processing/Data_analysis/noise-airq/reports/plots/voice_timeline_NOISE102.png

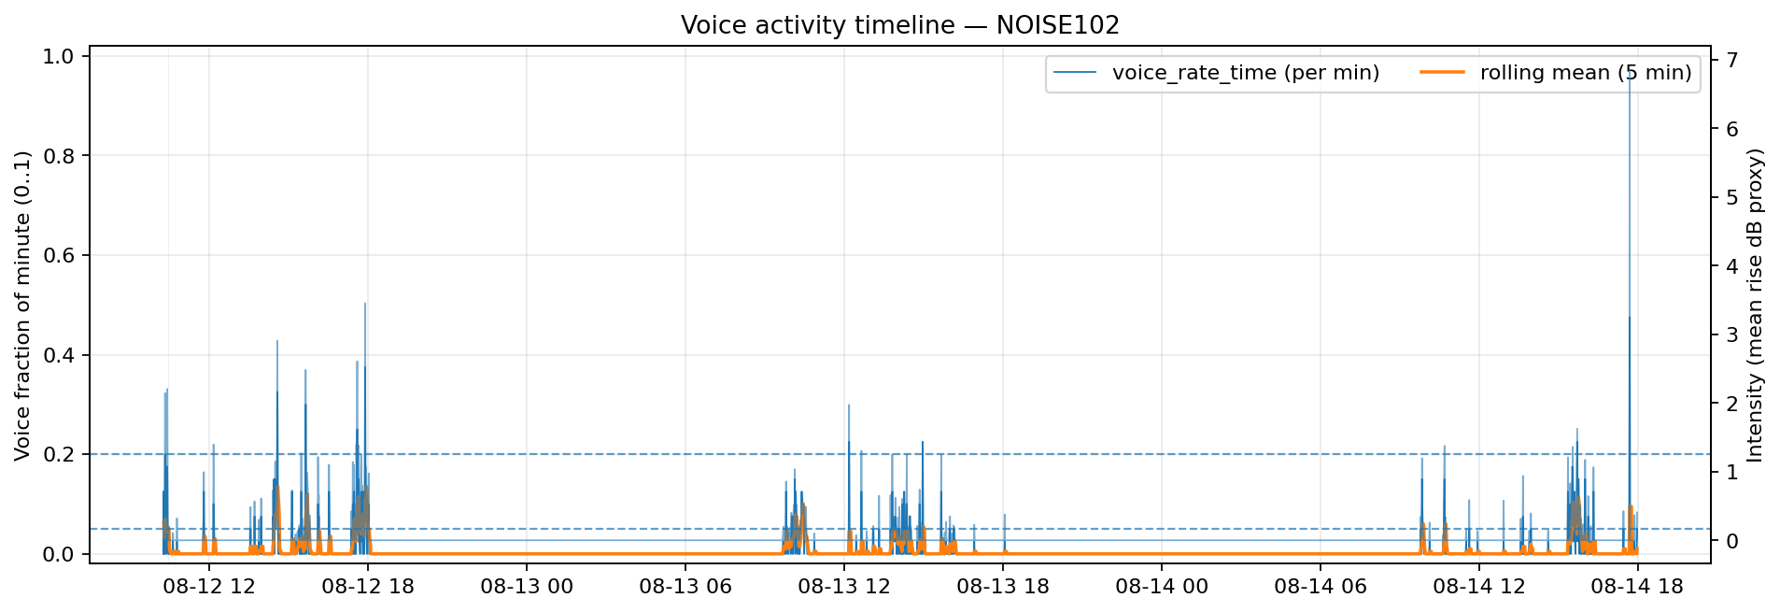
Data_processing/Data_analysis/noise-airq/reports/plots/voice_timeline_NOISE102.png
