pozdezh/Project_DELTA_Ph1/Data_processing/Data_analysis/noise-airq/reports/plots/voice_timeline_NOISE102_2025-08-12.png

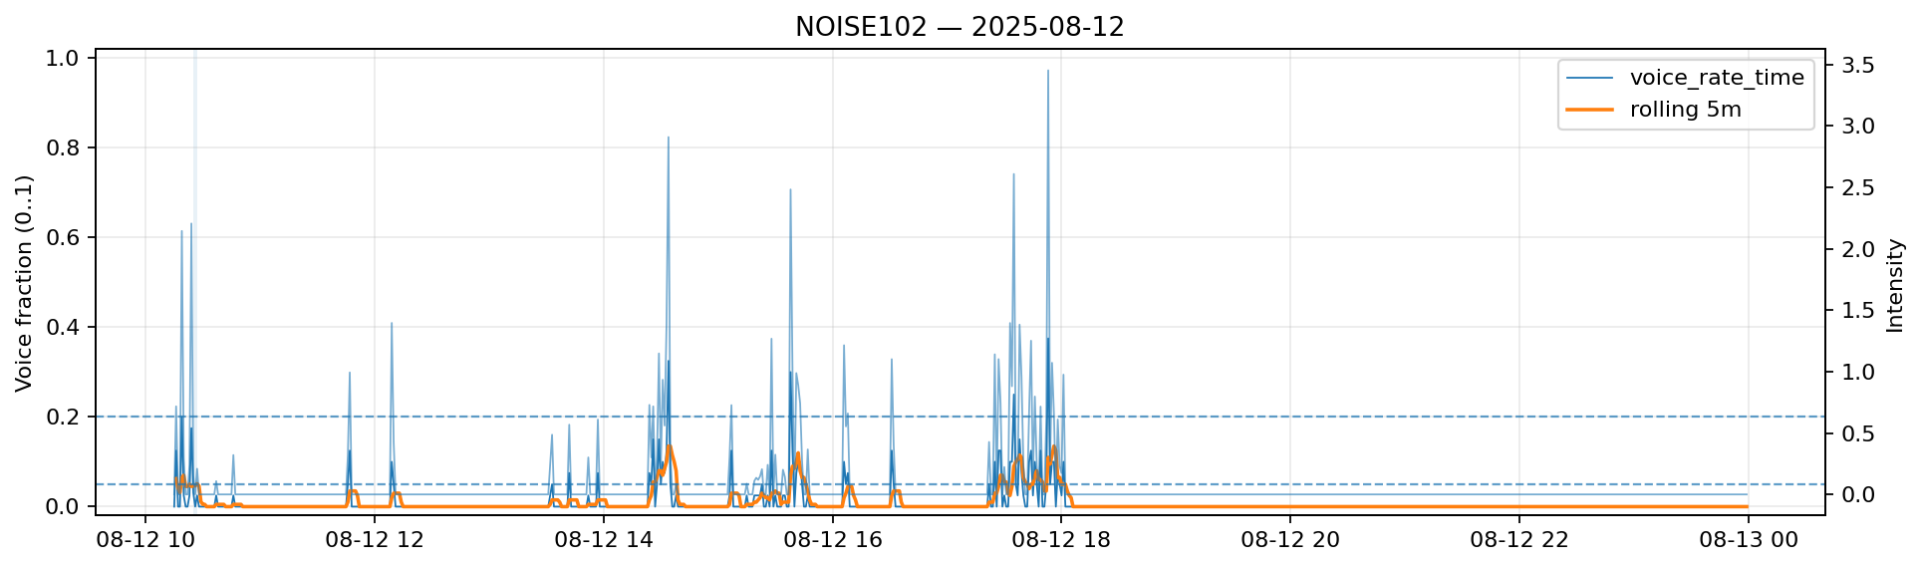
Data_processing/Data_analysis/noise-airq/reports/plots/voice_timeline_NOISE102_2025-08-12.png
