pozdezh/Project_DELTA_Ph1/Noise/3D_printing/Mic_Kit_Bottoms_v2.3mf

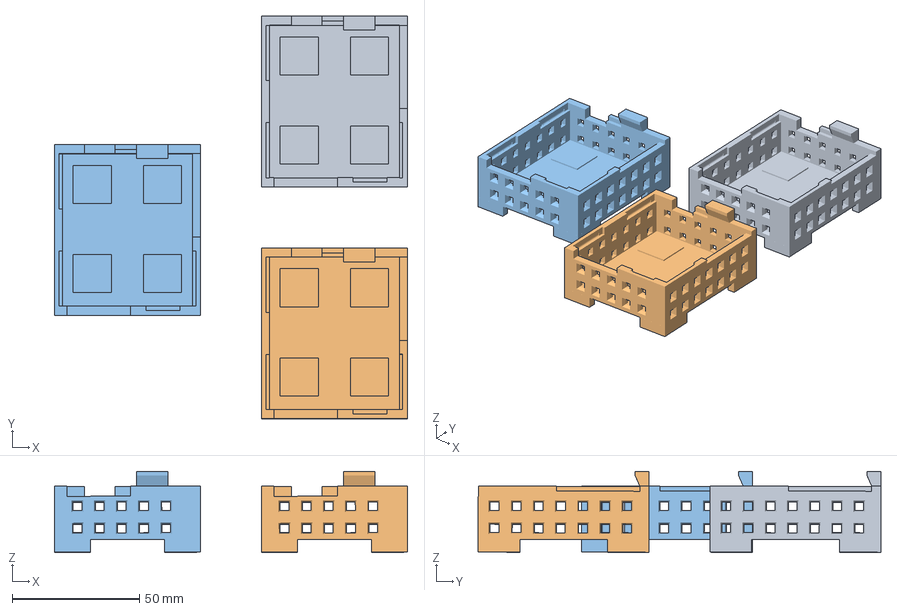
[picture p106: CAD file, 2025-08-27]
Noise/3D_printing/Mic_Kit_Bottoms_v2.3mf
138.9 x 158.5 x 31.9 mm
mic_kit_Bottom_v2.stl x 3
