pozdezh/Project_DELTA_Ph1/AirQ/3D_printing/bottom_V3.stl

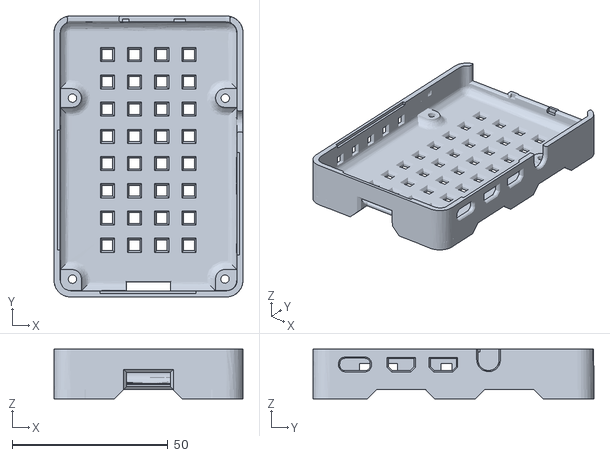
[picture p107: CAD file, 2025-08-18]
AirQ/3D_printing/bottom_V3.stl
60.6 x 90.1 x 16.0
