pozdezh/Project_DELTA_Ph1/Noise/3D_printing/mic_kit_Bottom_v2.stl

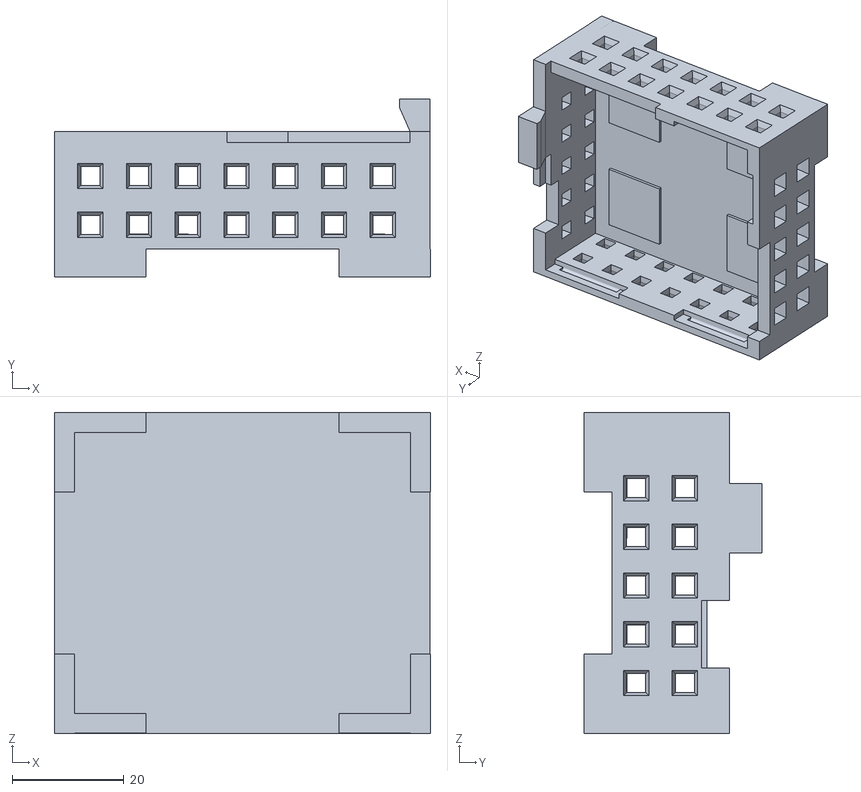
[picture p108: CAD file, 2025-08-27]
Noise/3D_printing/mic_kit_Bottom_v2.stl
67.3 x 31.8 x 57.4
