pozdezh/Project_DELTA_Ph1/AirQ/3D_printing/GASKIT_RELEASE_V3_Bottoms.3mf

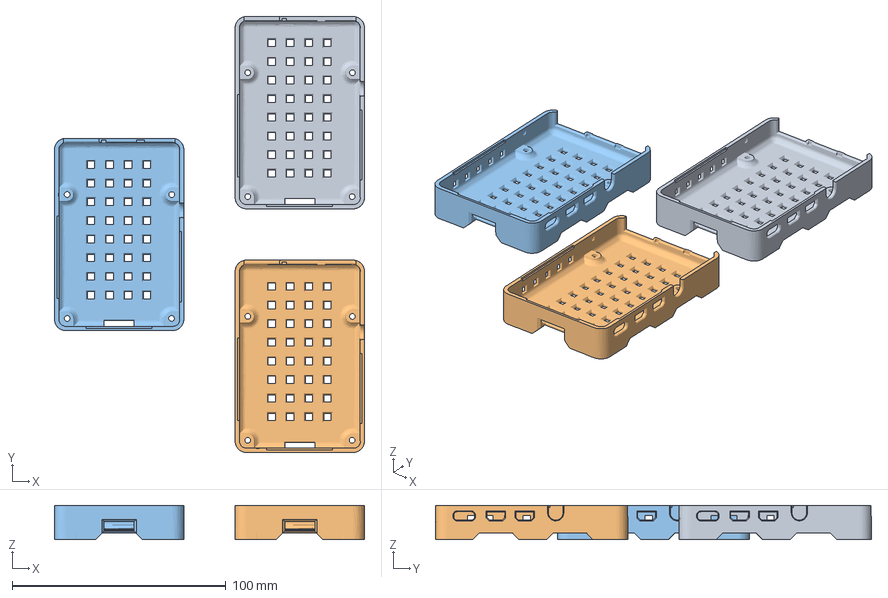
[picture p109: CAD file, 2025-08-18]
AirQ/3D_printing/GASKIT_RELEASE_V3_Bottoms.3mf
145.2 x 204.2 x 16.0 mm
bottom_V3.stl x 3
