pozdezh/Project_DELTA_Ph1/AirQ/3D_printing/top_V3.stl

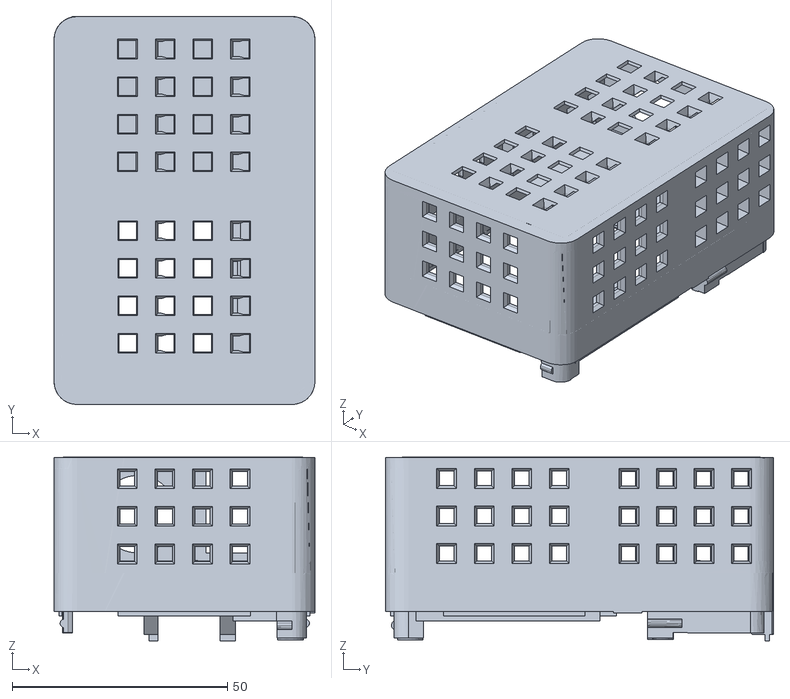
[picture p110: CAD file, 2025-08-18]
AirQ/3D_printing/top_V3.stl
60.6 x 90.1 x 42.6
