pozdezh/Project_DELTA_Ph1/Noise/3D_printing/Mic_Kit_Tops.3mf

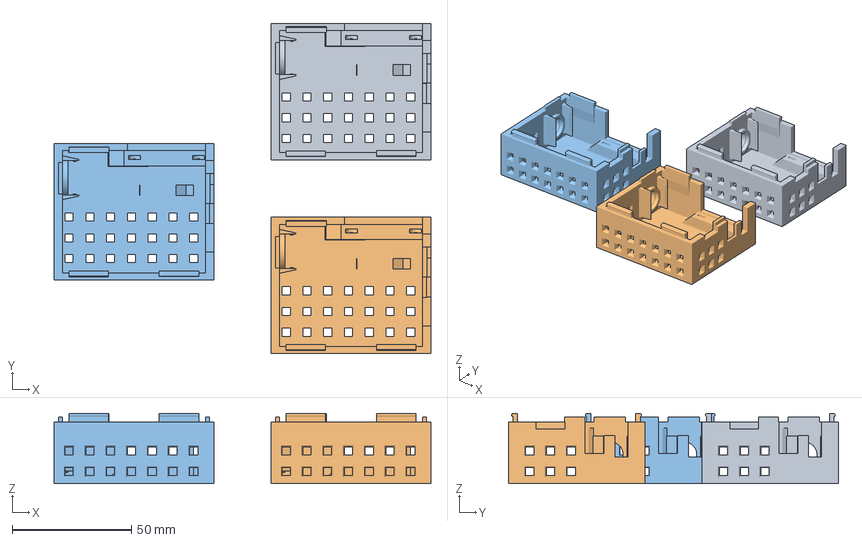
[picture p111: CAD file, 2025-08-17]
Noise/3D_printing/Mic_Kit_Tops.3mf
158.4 x 138.8 x 29.6 mm
mic_kit_top.stl x 3
