pozdezh/Project_DELTA_Ph1/Noise/3D_printing/mic_kit_top.stl

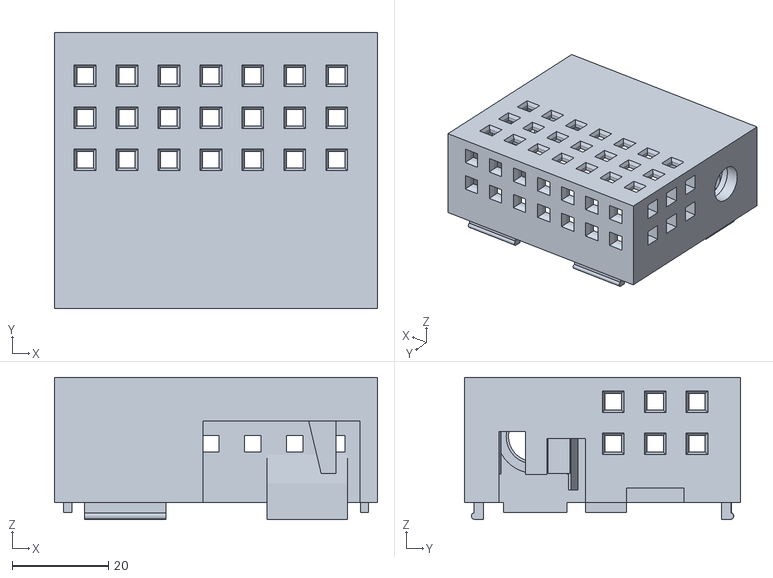
[picture p112: CAD file, 2025-08-17]
Noise/3D_printing/mic_kit_top.stl
67.2 x 57.4 x 29.6
