pozdezh/Project_DELTA_Ph1/AirQ/3D_printing/GASKIT_RELEASE_V3_Tops.3mf

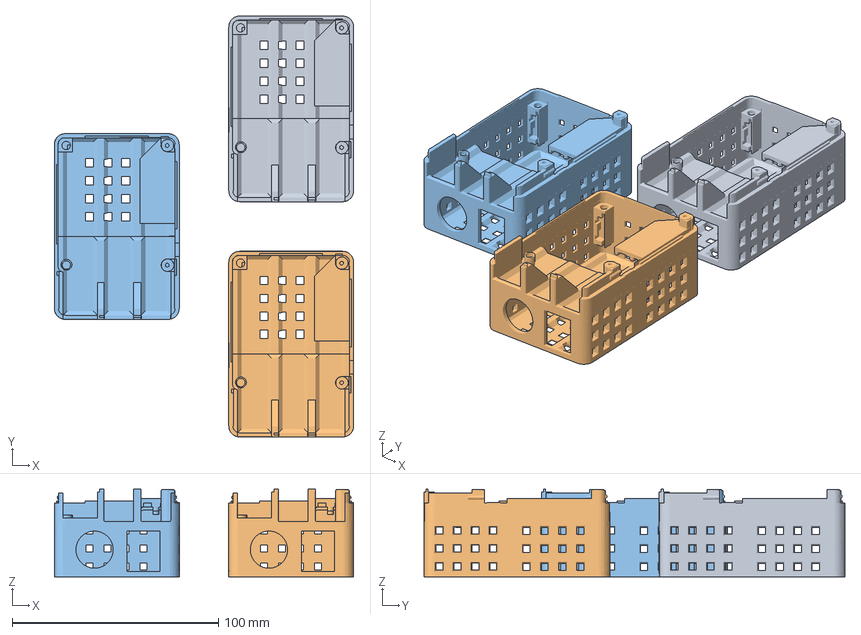
[picture p113: CAD file, 2025-08-18]
AirQ/3D_printing/GASKIT_RELEASE_V3_Tops.3mf
145.2 x 204.2 x 42.6 mm
top_V3.stl x 3
