pozdezh/Project_DELTA_Ph1/(list of files, cad)

Other CAD files:
AirQ/3D_printing/GASKIT_RELEASE_V3_2_Bottoms.gcode.3mf
Noise/3D_printing/Mic_Kit_Bottoms_v2.gcode.3mf
AirQ/3D_printing/GASKIT_RELEASE_V3_2_Tops.gcode.3mf
Noise/3D_printing/MICKIT_RELEASE_V1_Tops.gcode.3mf
