pozdezh/Project_DELTA_Ph1/Experiment_1/Noise_data/README.md

Noise kit actual data files too large to upload default way.
