pozdezh/Project_DELTA_Ph1/Experiment_1/AirQ_data/delta002_data.csv

id_sensor | id_parameter | value | created_at
SCD30 | TEMP | 25.12 | 2025-08-12 09:57:08
SCD30 | HUM | 67.73 | 2025-08-12 09:57:08
SCD30 | CO2 | 1352.56 | 2025-08-12 09:57:08
ENVIRO | TEMP | 2.39 | 2025-08-12 09:57:10
ENVIRO | HUM | 115.7 | 2025-08-12 09:57:10
ENVIRO | PRES | 648.66 | 2025-08-12 09:57:10
ENVIRO | LLUM | 3.21 | 2025-08-12 09:57:10
SCD30 | TEMP | 26.99 | 2025-08-12 10:05:58
SCD30 | HUM | 63.66 | 2025-08-12 10:05:58
SCD30 | CO2 | 1512.78 | 2025-08-12 10:05:58
ENVIRO | TEMP | 3.25 | 2025-08-12 10:06:07
ENVIRO | HUM | 115.7 | 2025-08-12 10:06:07
ENVIRO | PRES | 648.66 | 2025-08-12 10:06:07
ENVIRO | LLUM | 1.16 | 2025-08-12 10:06:07
DHT22 | TEMP | 18.75 | 2025-08-12 10:06:25
DHT22 | HUM | 87.1 | 2025-08-12 10:06:25
PMS5003 | PM1 | 6.02 | 2025-08-12 10:06:40
PMS5003 | PM25 | 9.51 | 2025-08-12 10:06:40
PMS5003 | PM10 | 10.95 | 2025-08-12 10:06:40
PMS5003 | UM03 | 1103.02 | 2025-08-12 10:06:40
PMS5003 | UM05 | 302.0 | 2025-08-12 10:06:40
PMS5003 | UM1 | 56.05 | 2025-08-12 10:06:40
PMS5003 | UM25 | 5.67 | 2025-08-12 10:06:40
PMS5003 | UM5 | 2.37 | 2025-08-12 10:06:40
PMS5003 | UM10 | 0.65 | 2025-08-12 10:06:40
SCD30 | TEMP | 25.52 | 2025-08-12 10:06:59
SCD30 | HUM | 69.62 | 2025-08-12 10:06:59
SCD30 | CO2 | 1514.64 | 2025-08-12 10:06:59
ENVIRO | TEMP | 17.4 | 2025-08-12 10:07:08
ENVIRO | HUM | 78.64 | 2025-08-12 10:07:08
ENVIRO | PRES | 1007.17 | 2025-08-12 10:07:08
ENVIRO | LLUM | 2.33 | 2025-08-12 10:07:08
DHT22 | TEMP | 18.95 | 2025-08-12 10:07:27
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
SCD30 | TEMP | 24.72 | 2025-08-12 13:20:52
SCD30 | HUM | 64.85 | 2025-08-12 13:20:52
SCD30 | CO2 | 2154.58 | 2025-08-12 13:20:52
PMS5003 | PM1 | 2.82 | 2025-08-12 13:21:16
PMS5003 | PM25 | 5.34 | 2025-08-12 13:21:16
PMS5003 | PM10 | 5.73 | 2025-08-12 13:21:16
PMS5003 | UM03 | 659.86 | 2025-08-12 13:21:16
PMS5003 | UM05 | 186.18 | 2025-08-12 13:21:16
PMS5003 | UM1 | 42.18 | 2025-08-12 13:21:16
PMS5003 | UM25 | 2.36 | 2025-08-12 13:21:16
PMS5003 | UM5 | 0.18 | 2025-08-12 13:21:16
PMS5003 | UM10 | 0.0 | 2025-08-12 13:21:16
DHT22 | TEMP | 25.35 | 2025-08-12 13:21:32
DHT22 | HUM | 66.6 | 2025-08-12 13:21:32
ENVIRO | TEMP | 22.38 | 2025-08-12 13:21:45
ENVIRO | HUM | 60.28 | 2025-08-12 13:21:45
ENVIRO | PRES | 1007.03 | 2025-08-12 13:21:45
ENVIRO | LLUM | 2.33 | 2025-08-12 13:21:45
SCD30 | TEMP | 24.72 | 2025-08-12 13:21:53
SCD30 | HUM | 65.05 | 2025-08-12 13:21:53
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
