pozdezh/Project_DELTA_Ph1/Data_processing/Data_analysis/noise-airq/test_fake/airq_1min_fake.csv

kit_code | ts_min_utc | CO2 | PM25 | PM10 | TEMP | HUM | PRES | LLUM
AIRQ777 | 2025-01-01 00:00:00 | 500.0 | 4.964786644951177 | 10.202543163563966 | 21.945650449206738 | 45.6861676452701 | 1013.0 | 120.0
AIRQ777 | 2025-01-01 00:01:00 | 500.0 | 5.053230918555335 | 10.031085865533694 | 22.25518472627822 | 45.85934613027113 | 1013.0262773668653 | 130.0
AIRQ777 | 2025-01-01 00:02:00 | 500.0 | 5.036544406436408 | 10.07035128167984 | 22.069765794011722 | 45.60256853696106 | 1013.0524821054579 | 130.0
AIRQ777 | 2025-01-01 00:03:00 | 500.0 | 5.041273261159599 | 10.010631069515574 | 21.98343611986648 | 45.42410240908103 | 1013.078541788243 | 130.0
AIRQ777 | 2025-01-01 00:04:00 | 500.0 | 5.043082100300788 | 10.000016878618283 | 22.09899012640798 | 45.31861187564552 | 1013.104384388607 | 130.0
AIRQ777 | 2025-01-01 00:05:00 | 504.4793626622022 | 5.214164760087046 | 9.85568839329143 | 21.909438756926583 | 45.497976870239036 | 1013.1299384799323 | 130.0
AIRQ777 | 2025-01-01 00:06:00 | 508.9587253244044 | 4.959358498361539 | 10.063298852334661 | 22.04880945197324 | 45.433939715607785 | 1013.155133433015 | 130.0
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
