pozdezh/Project_DELTA_Ph1/Data_processing/Data_analysis/noise-airq/test_fake/noise_voice_1min_fake.csv

kit_code | ts_min_utc | voice_rate_time | coverage_rate | frames
NOISE777 | 2025-01-01 00:00:00 | 0.746560443700367 | 1.0 | 30
NOISE777 | 2025-01-01 00:01:00 | 0.746560443700367 | 1.0 | 30
NOISE777 | 2025-01-01 00:02:00 | 0.746560443700367 | 1.0 | 30
NOISE777 | 2025-01-01 00:03:00 | 0.746560443700367 | 1.0 | 30
NOISE777 | 2025-01-01 00:04:00 | 0.746560443700367 | 1.0 | 30
NOISE777 | 2025-01-01 00:05:00 | 0.746560443700367 | 1.0 | 30
NOISE777 | 2025-01-01 00:06:00 | 0.746560443700367 | 1.0 | 30
NOISE777 | 2025-01-01 00:07:00 | 0.746560443700367 | 1.0 | 30
NOISE777 | 2025-01-01 00:08:00 | 0.746560443700367 | 1.0 | 30
NOISE777 | 2025-01-01 00:09:00 | 0.746560443700367 | 1.0 | 30
NOISE777 | 2025-01-01 00:10:00 | 0.444990595776847 | 1.0 | 30
NOISE777 | 2025-01-01 00:11:00 | 0.444990595776847 | 1.0 | 30
NOISE777 | 2025-01-01 00:12:00 | 0.444990595776847 | 1.0 | 30
NOISE777 | 2025-01-01 00:13:00 | 0.444990595776847 | 1.0 | 30
NOISE777 | 2025-01-01 00:14:00 | 0.444990595776847 | 1.0 | 30
NOISE777 | 2025-01-01 00:15:00 | 0.444990595776847 | 1.0 | 30
NOISE777 | 2025-01-01 00:16:00 | 0.444990595776847 | 1.0 | 30
NOISE777 | 2025-01-01 00:17:00 | 0.444990595776847 | 1.0 | 30
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
