pozdezh/Project_DELTA_Ph1/Data_processing/Data_analysis/noise-airq/reports_clean/AIRQ001_NOISE102/headline_results.csv

pair | scope | air_var | alt | noise_var | best_lag_min | N | Neff | pearson_r | r2 | r_CI95_lo | r_CI95_hi | p_adj | q_BH | decision | rev_max_abs_r | rev_max_lag | rev_noise_var
AIRQ001_NOISE102 | ALL | CO2 | greater | voice_rate_time | 10 | 3196 | 1409.7 | 0.114 | 0.013 | 0.062 | 0.165 | 8.697346366617384e-06 | 4.28741099268634e-05 | Reject H0 | 0.1010261141755899 | -2 | voice_rate_time
AIRQ001_NOISE102 | ALL | HUM | two-sided | voice_rate_time | 10 | 3245 | 1599.4 | 0.083 | 0.007 | 0.034 | 0.132 | 0.0008845157077080658 | 0.009729672784788724 | Reject H0 | 0.07958937438289768 | -1 | voice_rate_time
AIRQ001_NOISE102 | ALL | PM10 | greater | voice_rate_time | 8 | 1921 | 1028.5 | 0.06 | 0.004 | -0.002 | 0.12 | 0.02818115326630114 | 0.18278167739506473 | Fail to reject H0 | 0.05248479603956581 | -10 | voice_rate_time
AIRQ001_NOISE102 | ALL | PM25 | greater | voice_rate_time | 8 | 1921 | 1027.8 | 0.06 | 0.004 | -0.001 | 0.121 | 0.02628595038364135 | 0.16990126592669857 | Fail to reject H0 | 0.0554845818090624 | -10 | voice_rate_time
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
