pozdezh/Project_DELTA_Ph1/Data_processing/Data_analysis/noise-airq/reports_clean/AIRQ002_NOISE102/headline_results.csv

pair | scope | air_var | alt | noise_var | best_lag_min | N | Neff | pearson_r | r2 | r_CI95_lo | r_CI95_hi | p_adj | q_BH | decision | rev_max_abs_r | rev_max_lag | rev_noise_var
AIRQ002_NOISE102 | ALL | CO2 | greater | voice_rate_time | 10 | 3196 | 1450.6 | 0.121 | 0.015 | 0.07 | 0.171 | 1.963409985638744e-06 | 2.1597509842026185e-05 | Reject H0 | 0.09982494122150752 | -4 | voice_rate_time
AIRQ002_NOISE102 | ALL | HUM | two-sided | voice_rate_time | 8 | 3250 | 1495.3 | 0.036 | 0.001 | -0.015 | 0.087 | 0.16296206192668003 | 0.3813260220485856 | Fail to reject H0 | 0.03816951600985461 | -4 | voice_rate_time
AIRQ002_NOISE102 | ALL | PM10 | greater | voice_rate_time | 8 | 1921 | 1079.0 | 0.044 | 0.002 | -0.016 | 0.103 | 0.07474188525537581 | 0.32517802352656455 | Fail to reject H0 | 0.04699673064233752 | -10 | voice_rate_time
AIRQ002_NOISE102 | ALL | PM25 | greater | voice_rate_time | 8 | 1920 | 1077.8 | 0.045 | 0.002 | -0.015 | 0.105 | 0.06894538650085992 | 0.323242956578586 | Fail to reject H0 | 0.050271706114795464 | -10 | voice_rate_time
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
