pozdezh/Project_DELTA_Ph1/AirQ/Code/config/sensors.ini

[enviro]
tag = ENVIRO
connection = 0
frequency = 1
active = 1
port = 2999

[PMS]
tag = PMS5003
connection = 0
frequency = 1
active = 1
port = 3000

[SCD30]
tag = SCD30
connection = 0
frequency = 1
active = 1
port = 3001

[DHT22]
tag = DHT22
connection = 4
frequency = 1
active = 1
port = 3002
